rafibuet12/4bitSAP/Proteus Files+Others/4 BIT TOY.JPG

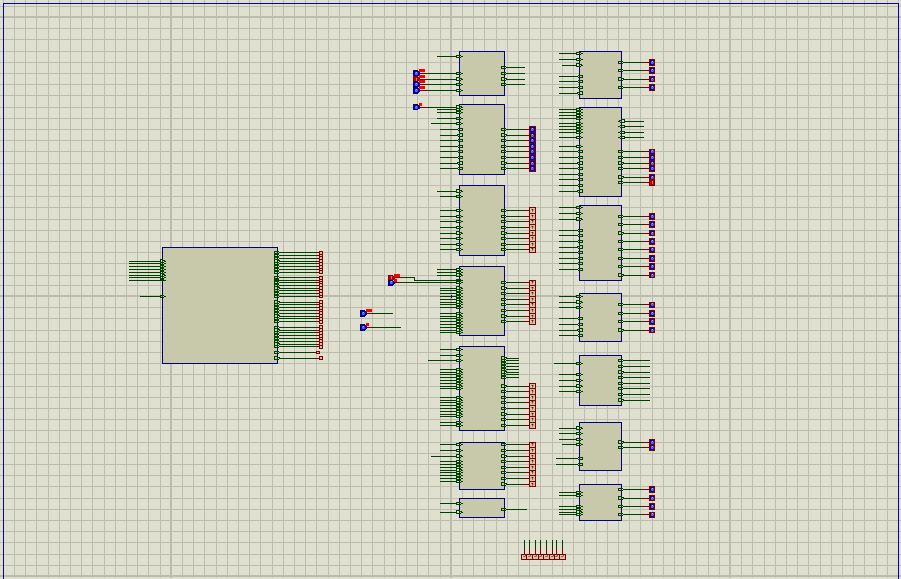
Proteus Files+Others/4 BIT TOY.JPG
