rafibuet12/4bitSAP/Report/4bit PC Report.pdf

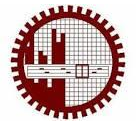
[picture p2: figure]

CSE404

Digital Systems Design Sessional
Design of 4-bit SAP
Section | B1
Group No. | 03
Writer’s Roll | 1205016
Writer’s Name | Rashid Abid Rafi
Group Members | 1205016 1205026 1205028 1205034 1205052
Date of Submission: | 15 November 2016

General Discussion & BLOCK DIAGRAM:

- Address BUS 8bit
- DATA bus 4 bit
- All data loading from BUS are sequential (Lsth) and all data emitting to BUS are combinational (Esth) (e.g: sth= MAR,MDR,IR etc.)
- The machine is edge triggered and both falling edge and rising edge are used in specific cases to perform specific purposes to avoid race conditions.

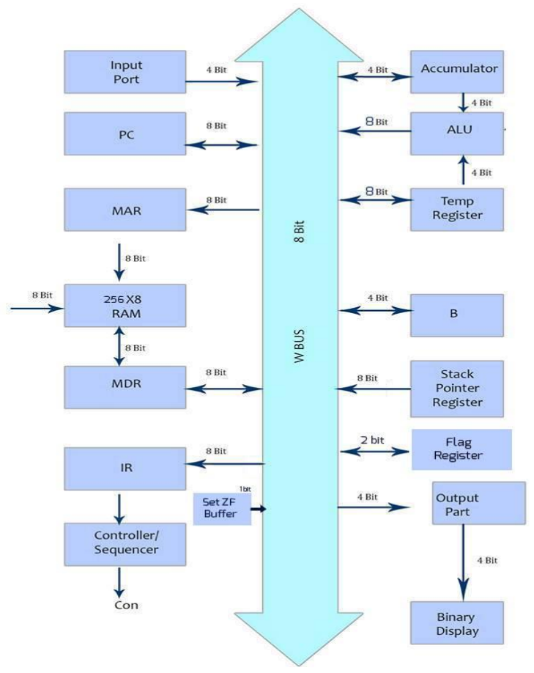
[picture p3: figure]

Input Register:

It is unidirectional with the bus: it only gives its data to the bus. That’s why only EIN. The task of input register is to take user input and pass the data to Accumulator via bus.

It is a data register, so only 4 bit transaction will suffice.

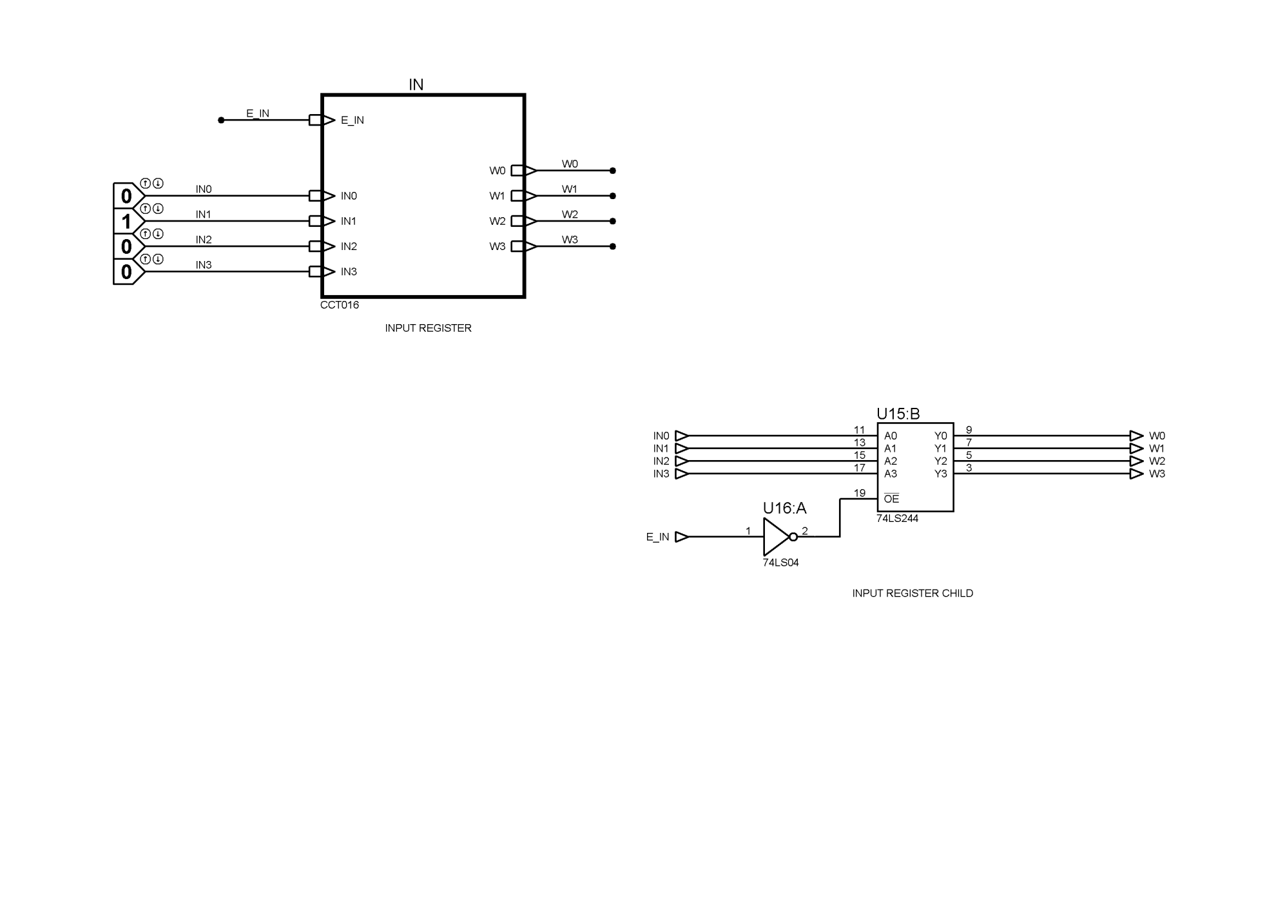
[picture p4: page 5]

PROGRAM COUNTER (PC):

PC is bidirectional with the bus. LPC loads data from the bus in a clock cycle and EPC lets it emit his data to the bus.

PC is an address register. That’s why it performs transactions in 8 bit.

There is a special bit PC_SP_SETUP in the design. There is a reason it is there. Eventually, when we will discover our RAM, we will see that the RAM stores data from the 1st address instead of 0th address. For this reason, PC is incremented by 1 forcefully at the beginning of running any program.

So, the incrementing needs a choice:

i) PC gets incremented by one at the beginning of the program by turning PC_SP_SETUP 1 forcefully.
ii) PC gets incremented when CP is 1 at the time of program running.

The MUX in this design selects between these two choices.

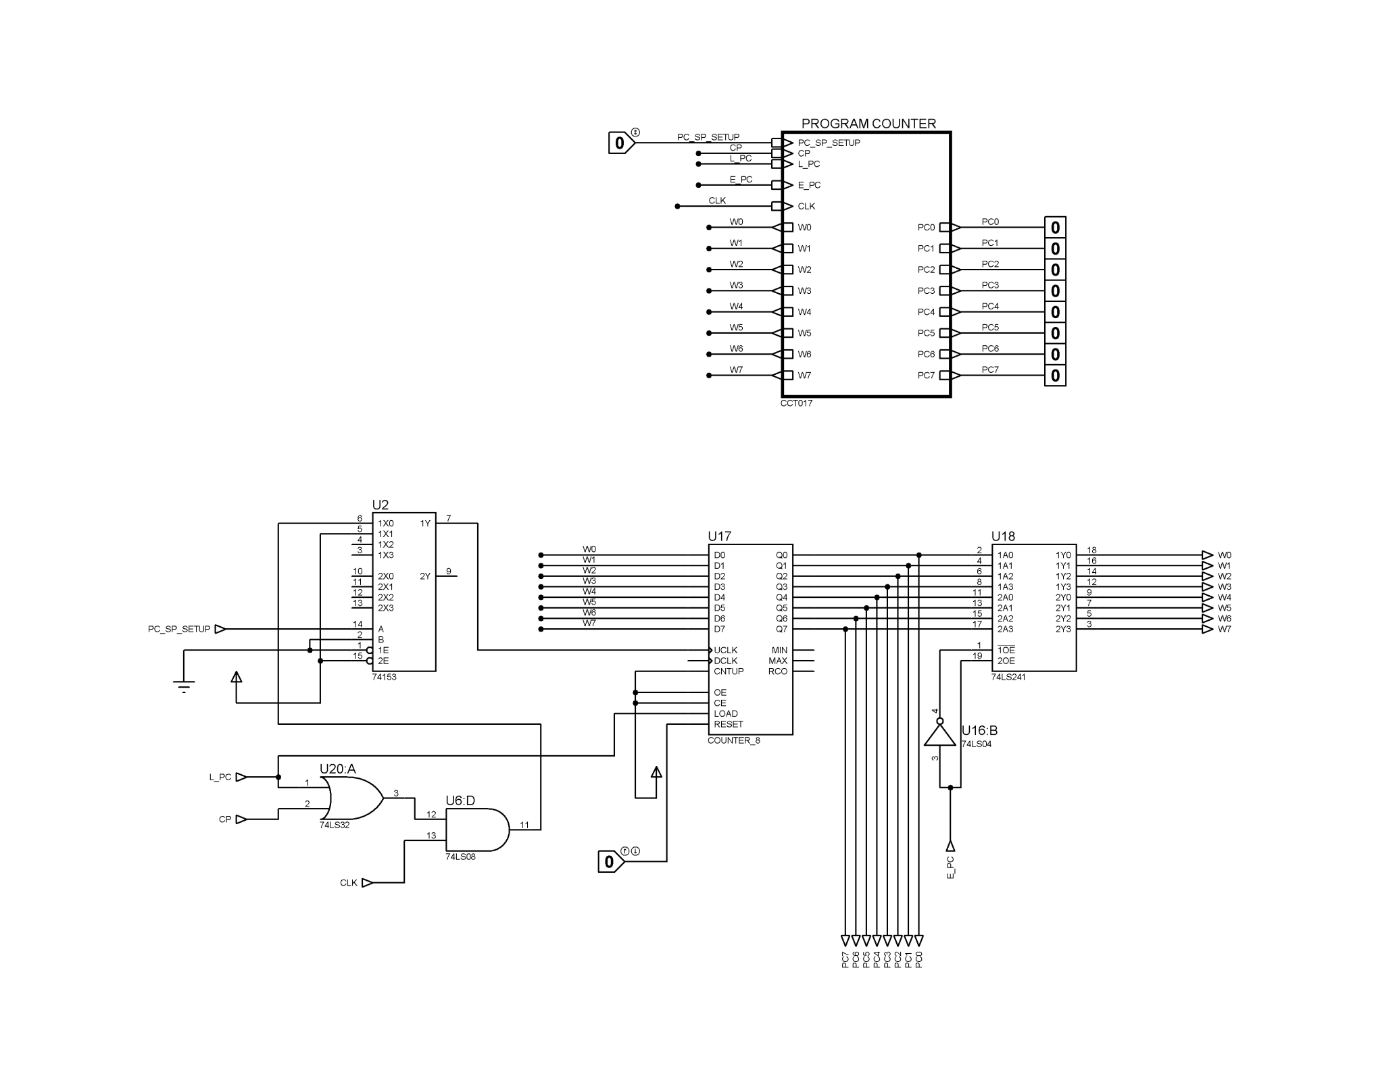
[picture p5: page 7]

MAR (Memory Address Register):

It is unidirectional with the bus: it only loads data from the bus. That’s why only LMAR.

The part of MAR with RAM is combinational. That means, whenever there is a data in MAR, RAM points to that address in the same clock cycle.

It is also an address register, hence 8 bit transaction.

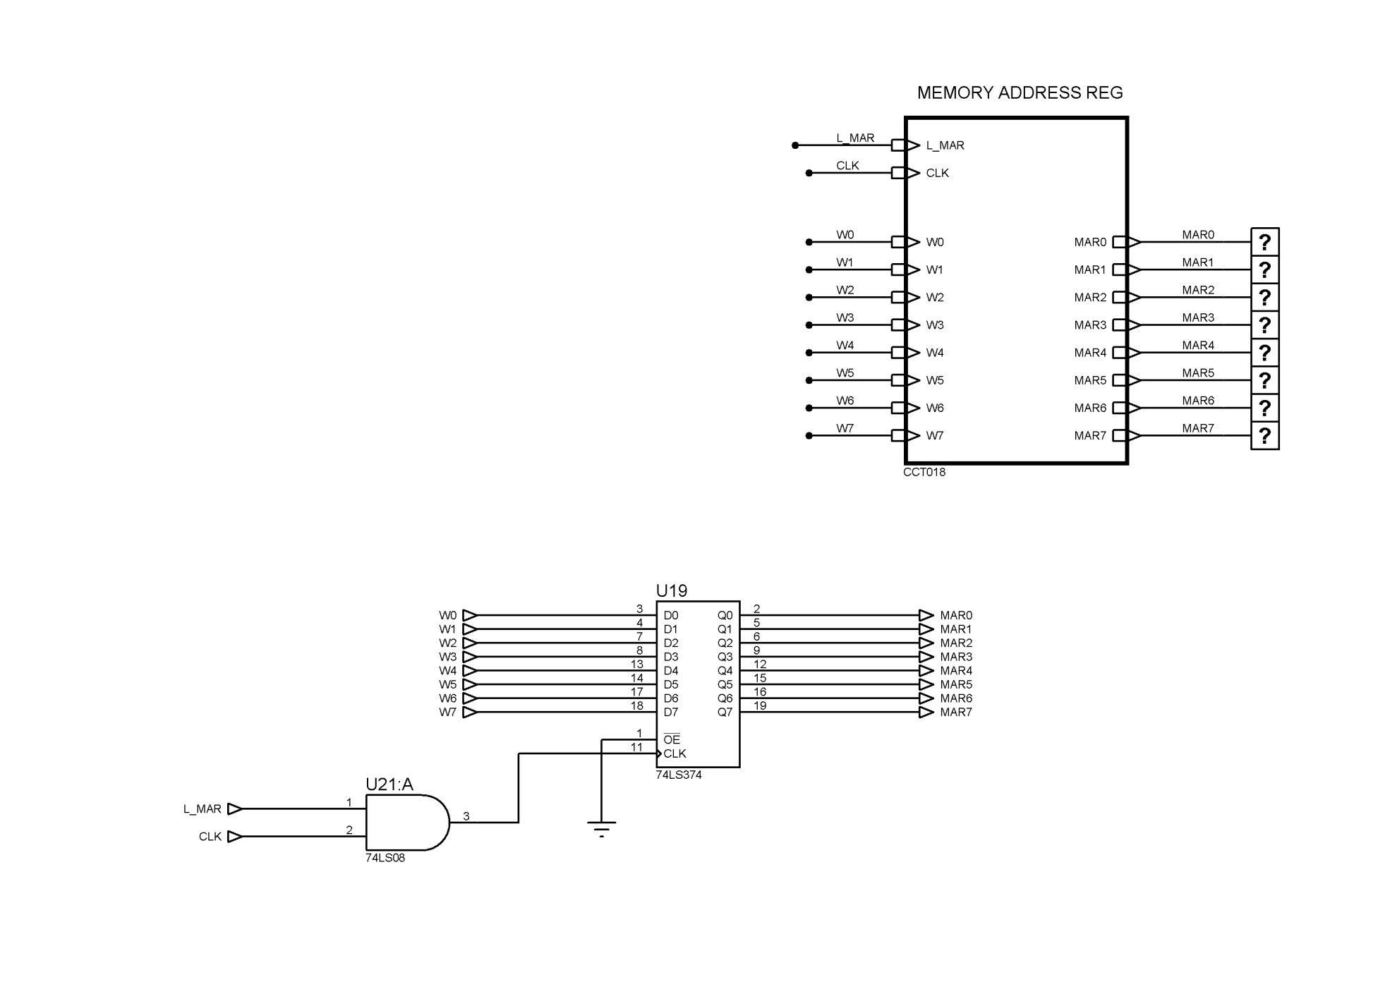
[picture p6: page 9]

RAM (Random Access Memory):

Our address bit is 8 bit. So, we need to implement a 256x8 RAM.

There is no connection of BUS with RAM directly. In fact, the design was specific about this not to have any direct connection with the BUS. For this reason, the two registers: MAR & MDR are used.

The whole design constitutes of two parts:

i) Uploader/ Boot-Loader : When Up_INIT is on, with every clock pulse at UP_INIT_CLK, the assembly program, which the PC is about to run, pre-saved in the EPROM in the form of Machine Language gets loaded byte by byte and written into RAM.
ii) | Normal Read/Write Operation: Only after the whole assembly program is loaded
| into RAM, typical read/write operations starts according to the CLK and R_RAM,
| W_RAM bit.

Functionality:

- Read Operation: When there is CE(Chip Enable) on and WE(Write Enable) off, provided that OE(output Enable) always remains on, a read operation happens. It reads the data from the address A0-A7 and outputs data into the D0-D7 pins.
- Write Operation: When there is CE(Chip Enable) on and WE(Write Enable) on, provided that OE(output Enable) always remains on, a write operation happens. It writes the data from the data pins D0-D7 into the address specified in A0-A7 pins.
- MUX: The ram operates to serve two purposes. One is for boot-loading the program and the other is the normal read/write operation. For this choice making, a MUX is used along with proper combinational logic to control the RAM.

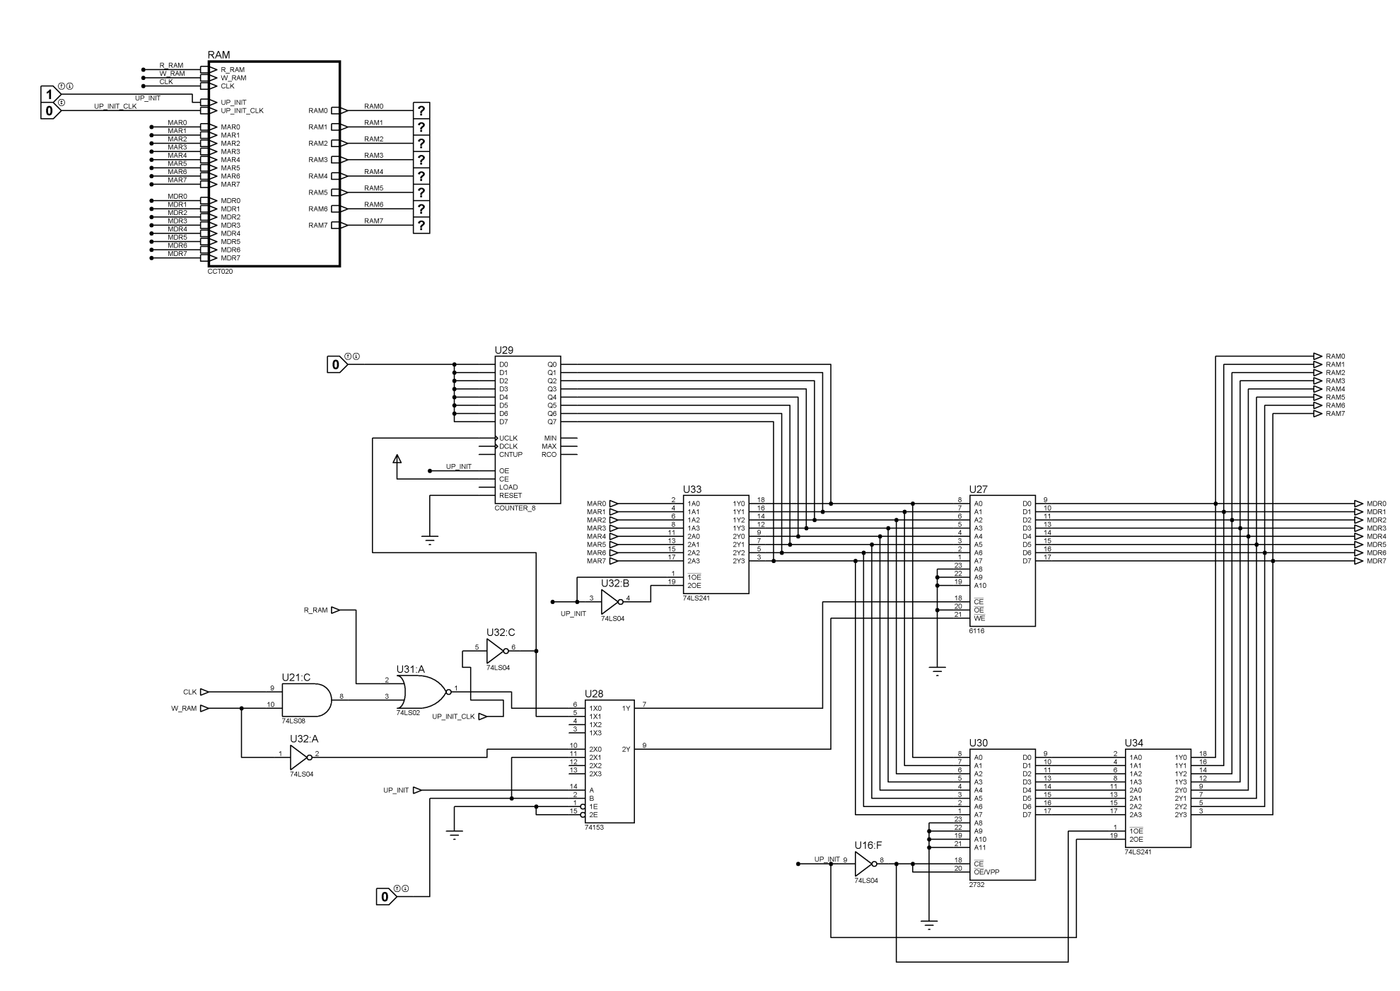
[picture p7: page 12]

MDR (Memory Data Register):

MDR is bidirectional with the bus. That’s why LMDR & EMDR.

It can contain 4 bit data or 8 bit address as a data, too. That’s why it is 8 bit register.

MDR is bidirectional with RAM, too.

i) When R_RAM is on, MDR reads data from RAM and stores within. It needs a clock cycle.
ii) | When W_RAM is on, MDR writes its data at RAM at the address pointed by MAR.
| It needs a clock cycle.

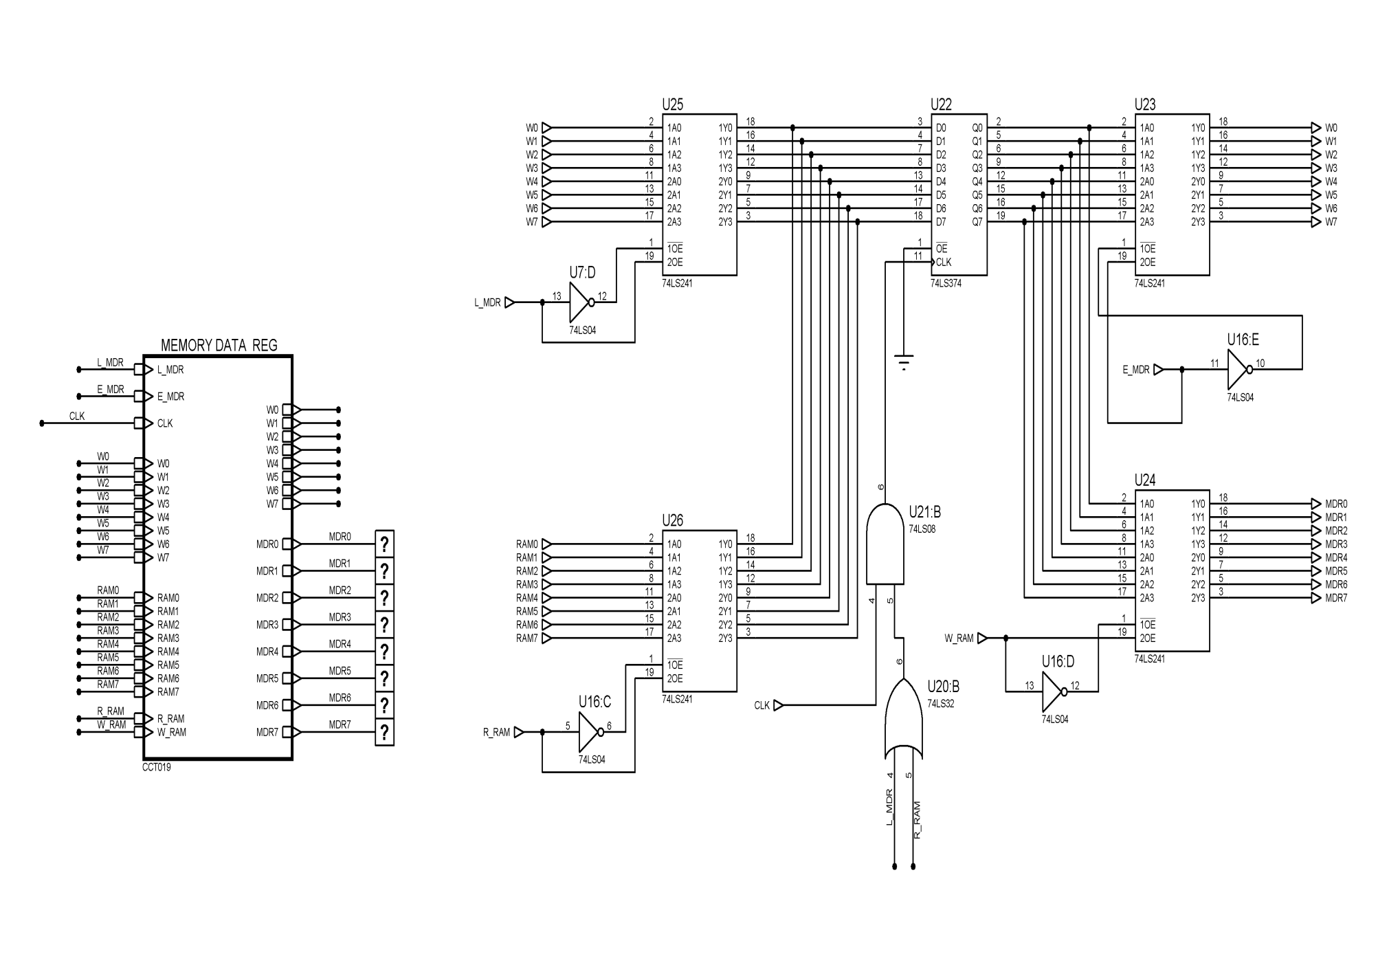
[picture p8: page 14]

IR (Instruction Register) :

It is unidirectional with the bus. It only loads data from bus.

i) L_IR1 loads 6 bit from bus. The first 5 bit(bit0-bit4) is the opcode.
ii) L_IR2 loads 2 bit from bus. These are the two flag bits: Carry Flag(bit6) and the Zero Flag (MSB or bit7).

It has a combinational connection with the CONTROLLER. That means, it passes its 8 bit data directly to the controller.

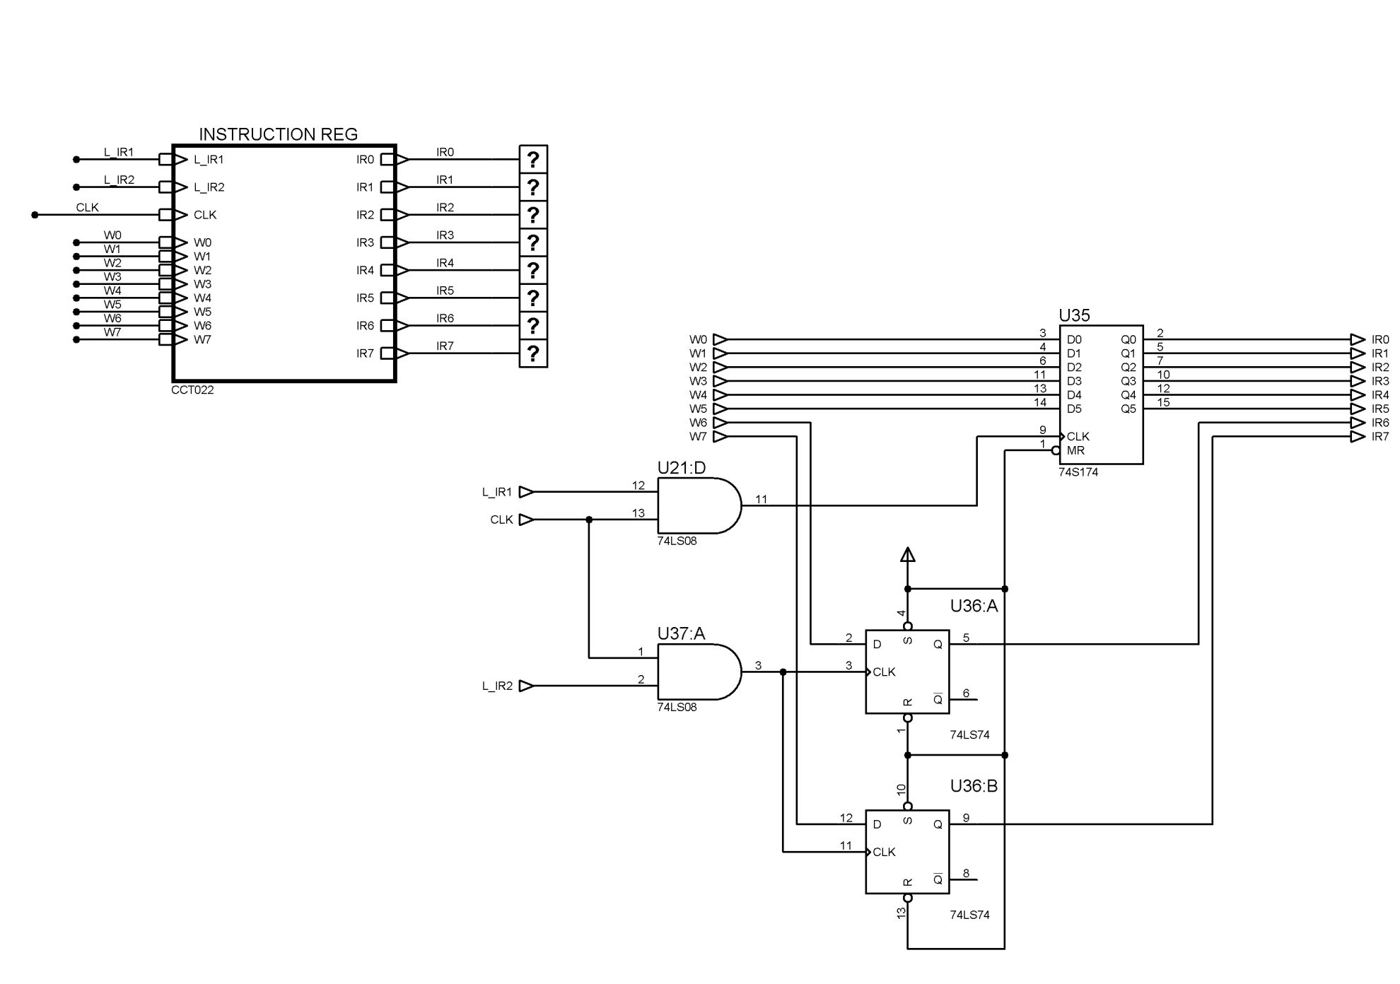
[picture p9: page 16]

SET ZF BUF (Set Zero Flag Buffer):

It is a tri-state buffer. Its job is to set/ clear the W7 bit (MSB) of bus.

It is a buffer, so unidirectional with the bus and hence ESET_ZF_BUF

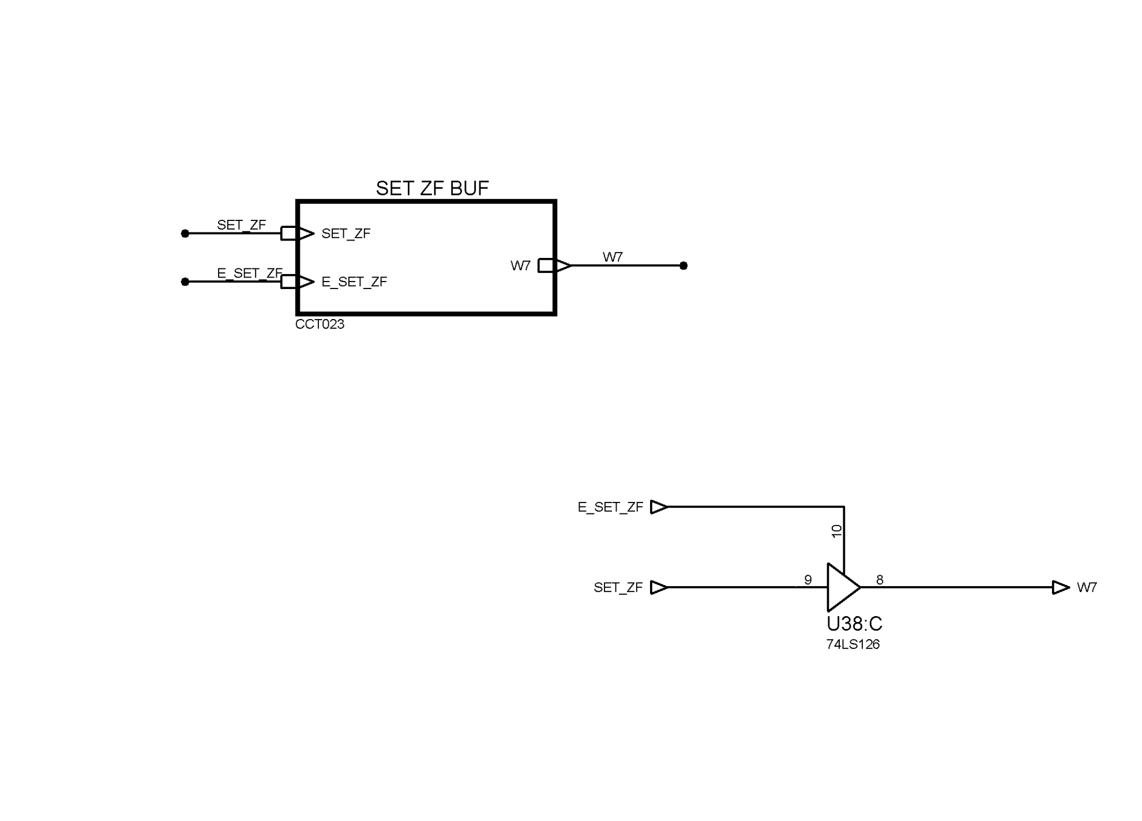
[picture p10: page 18]

ACCUMULATOR:

It is bi-directional with the bus. Hence, LA & EA.

It has a combinational connection with the ALU. That means, whenever there is data in Accumulator, it passes to ALU in the same clock cycle.

It is a data register, hence 4 bit transaction.

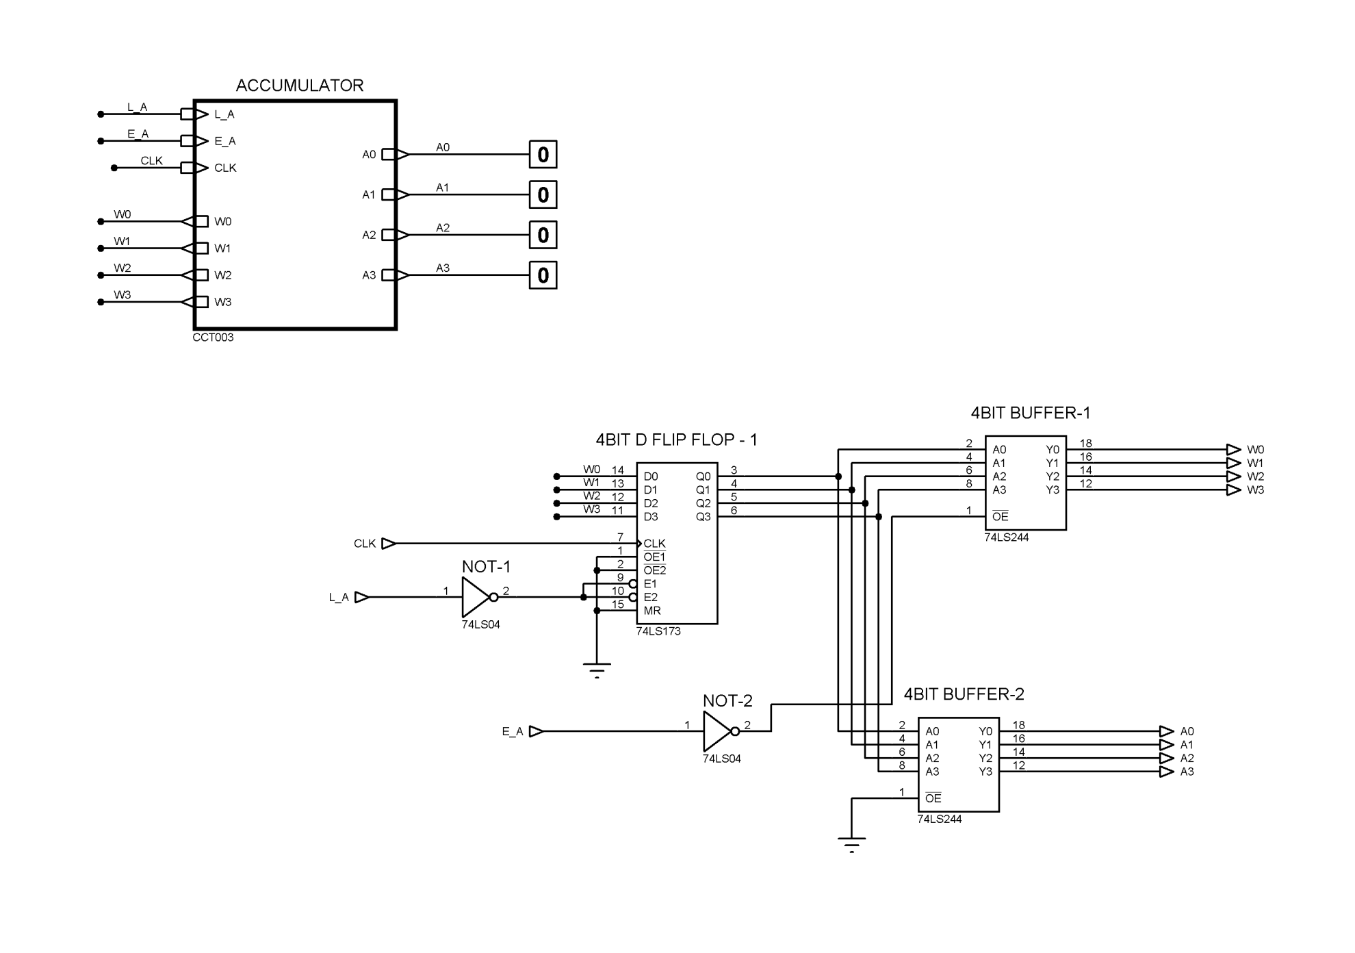
[picture p11: page 20]

ALU (Arithmetic Logic Unit):

The design is called 4-bit PC because our ALU operates on 4 bit data. There are direct connections from Accumulator & Temp Reg to ALU. That means, as soon as the data in these two updates, ALU performs its operation according to its control bits.

i) EALU lets ALU emit its data to bus
ii) EADD & ESUB performs the arithmetic operation.
iii) EAND & EOR performs the logical operation.

If we notice, we can see that there is no direct connection from ALU to FLAG Register. That means, whenever ALU performs an operation, the corresponding flags are to set by us manually. For this reason, ALU computes the flags each time an operation happens and it sends them in W6-W7 (Carry Flag and Zero Flag respectively), whereas the computed 4 bit data is sent to W0-W3.

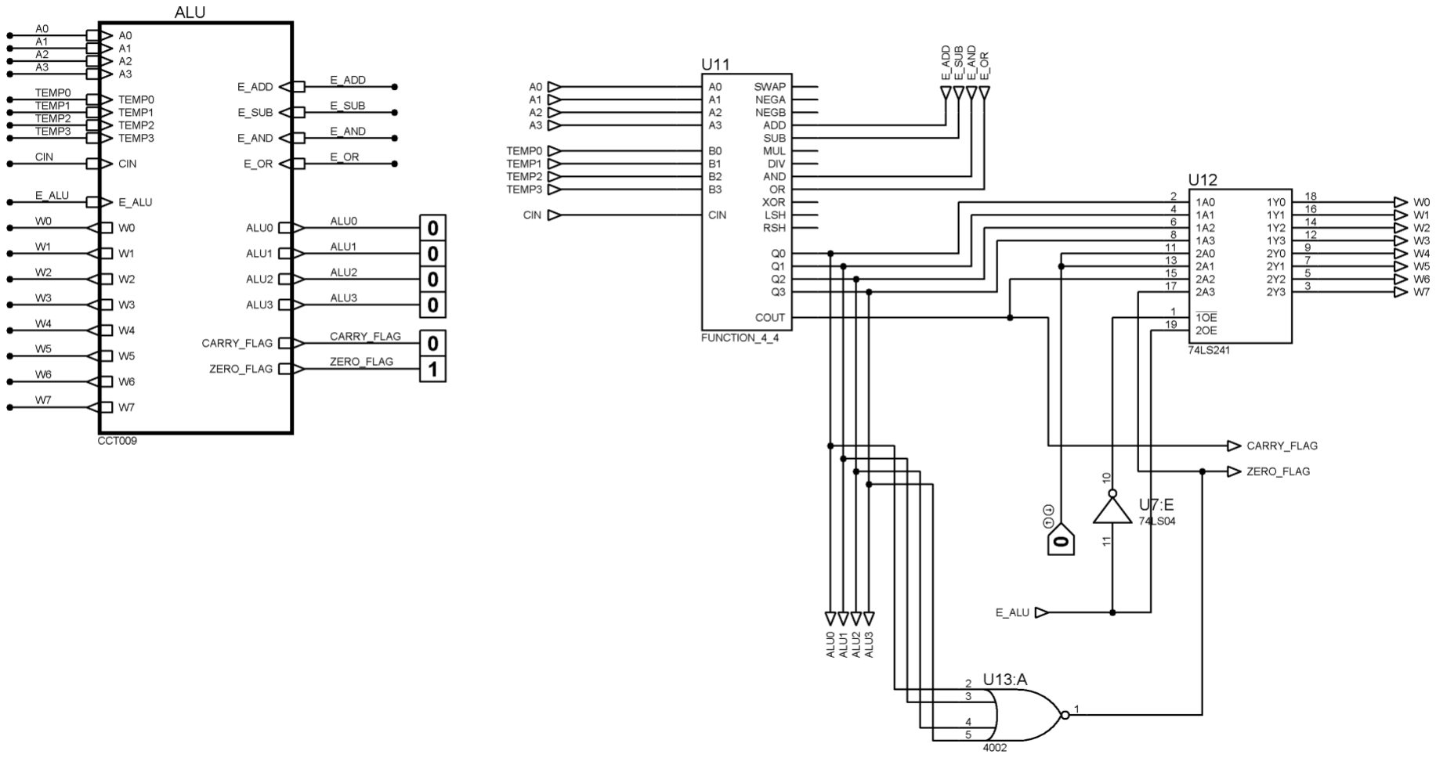
[picture p12: figure]

TEMP Register:

It is bidirectional with the bus, hence LTEMP & ETEMP.

It has a direct connection with ALU. That means, whenever the data in TEMP changes, ALU updates.

In our design, TEMP Register can also hold address value temporary. That’s why its 8 bit register in design.

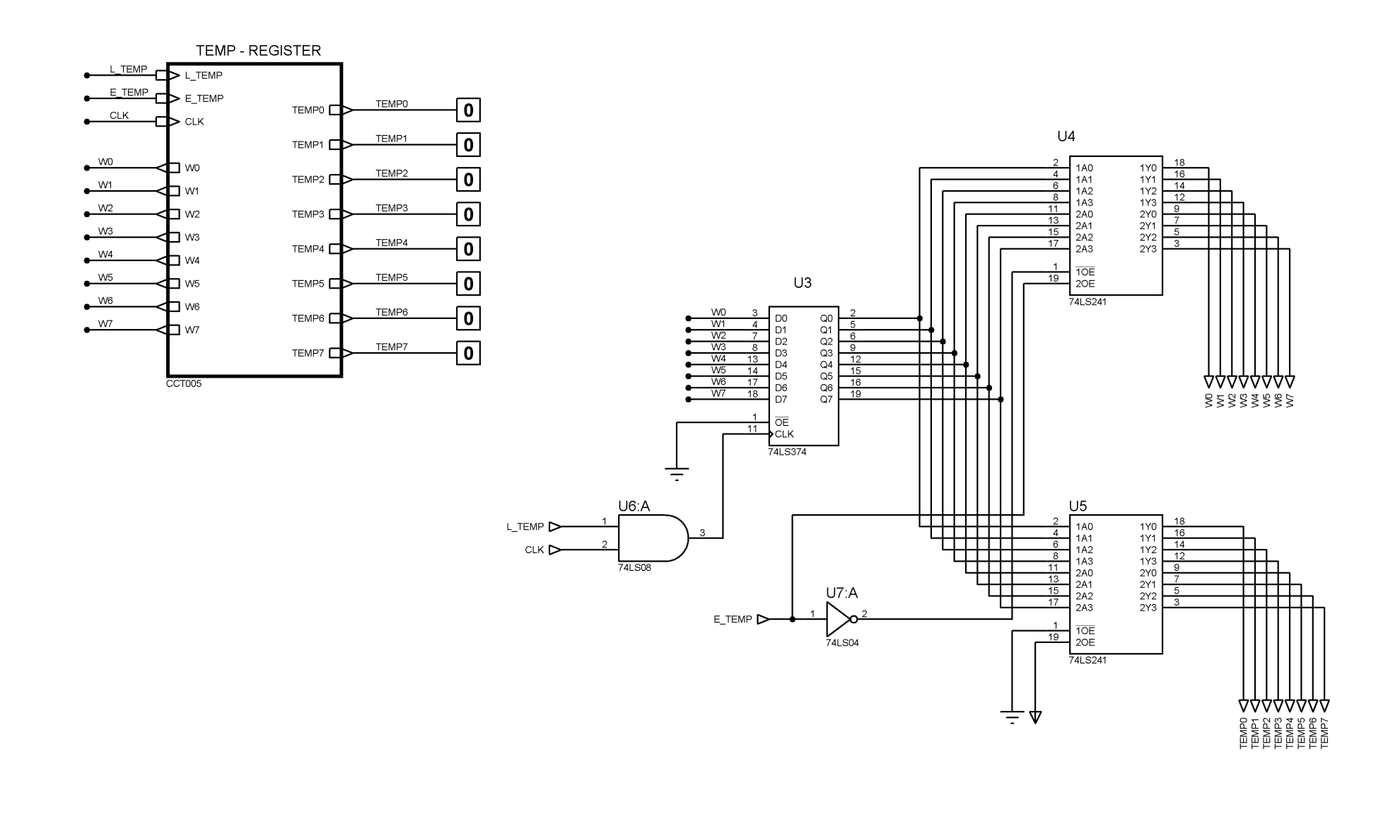
[picture p13: figure]

B Register:

It is also a bidirectional data register like Accumulator unlike it has no connection with ALU directly. Any data from B Register goes to ALU via Temp Register.

Its bidirectional with bus, hence LB & EB.

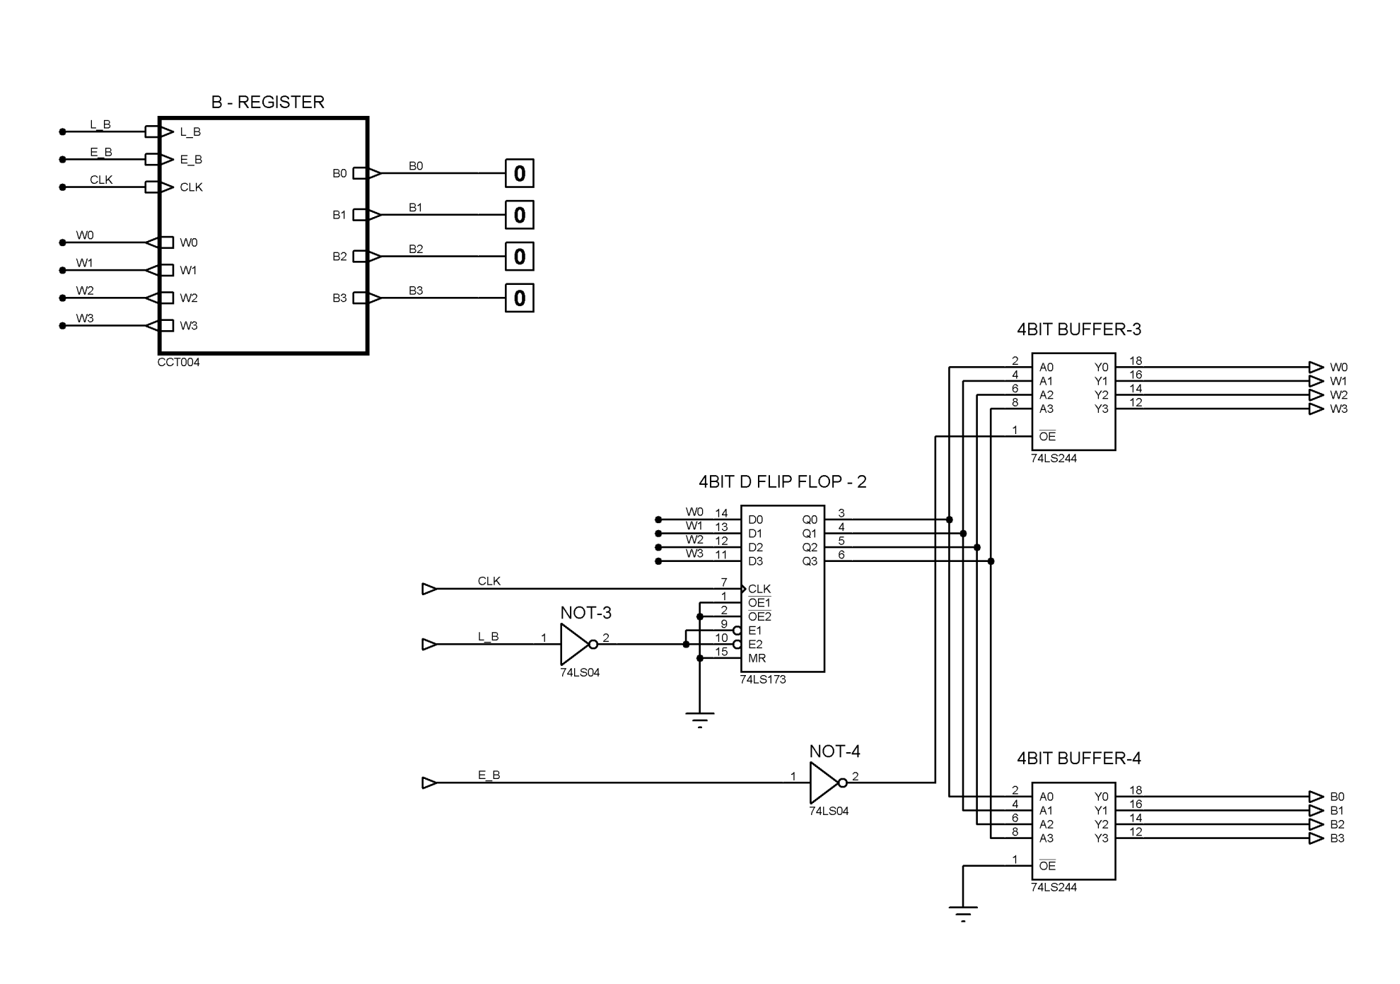
[picture p14: page 26]

STACK POINTER:

This register manages the TOP of the stack. It always holds the address of the TOP of the stack.

It has a special bit PC_SP_SETUP. It initially sets SP address to the desired address location at the beginning of the program running.

It can both increase and decrease, that’s why USP (Up Counter)& DSP (Down Counter).

It is unidirectional with the bus, it can only give its data to the Bus. Hence, ESP.

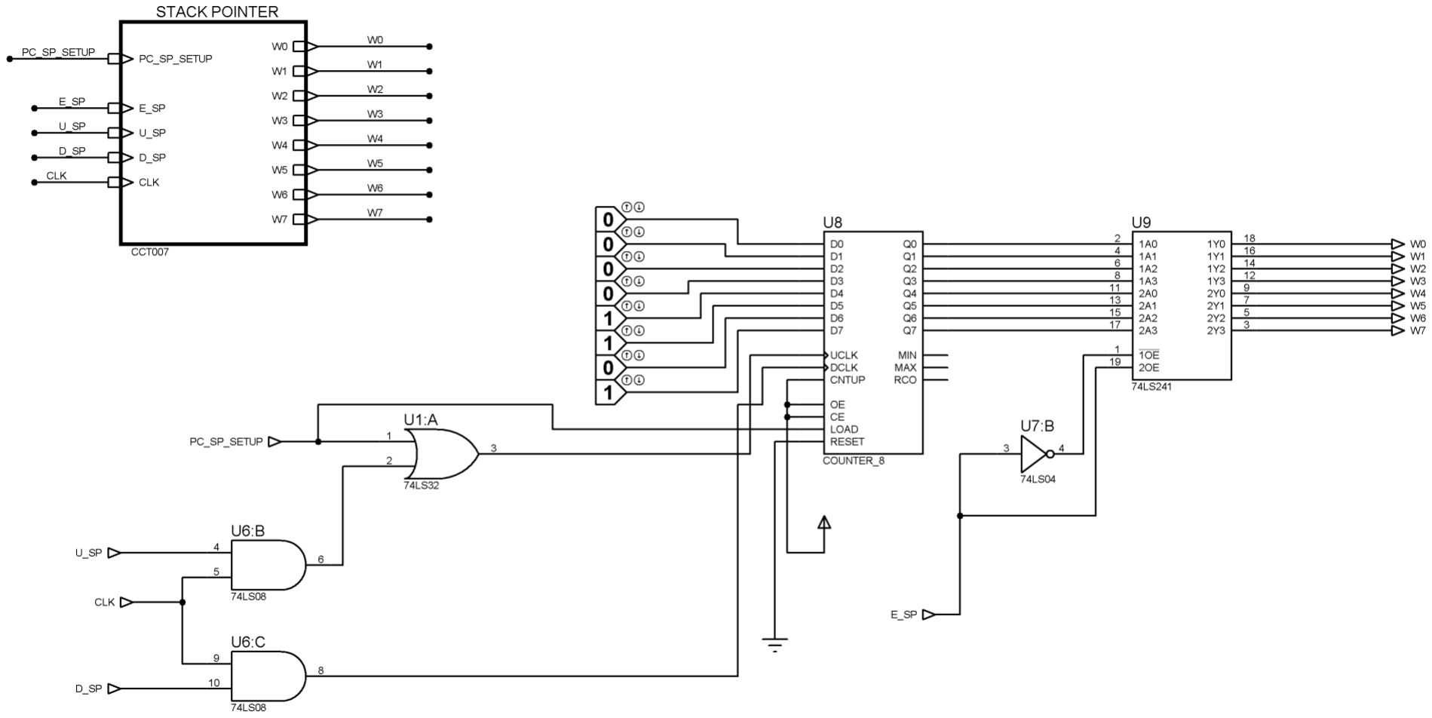
[picture p15: figure]

FLAGS REGISTER:

It is 2 bit data register. It just loads W6 & W7 bit bus data and saves in it as Carry Flag(W6) and Zero Flag (W7).

i) L_FLAGS loads both CF & ZF
ii) L_FLAGS_Z loads only W7 data (ZF)
iii) E_FLAGS lets it emit its 2 flags in 2 bits.

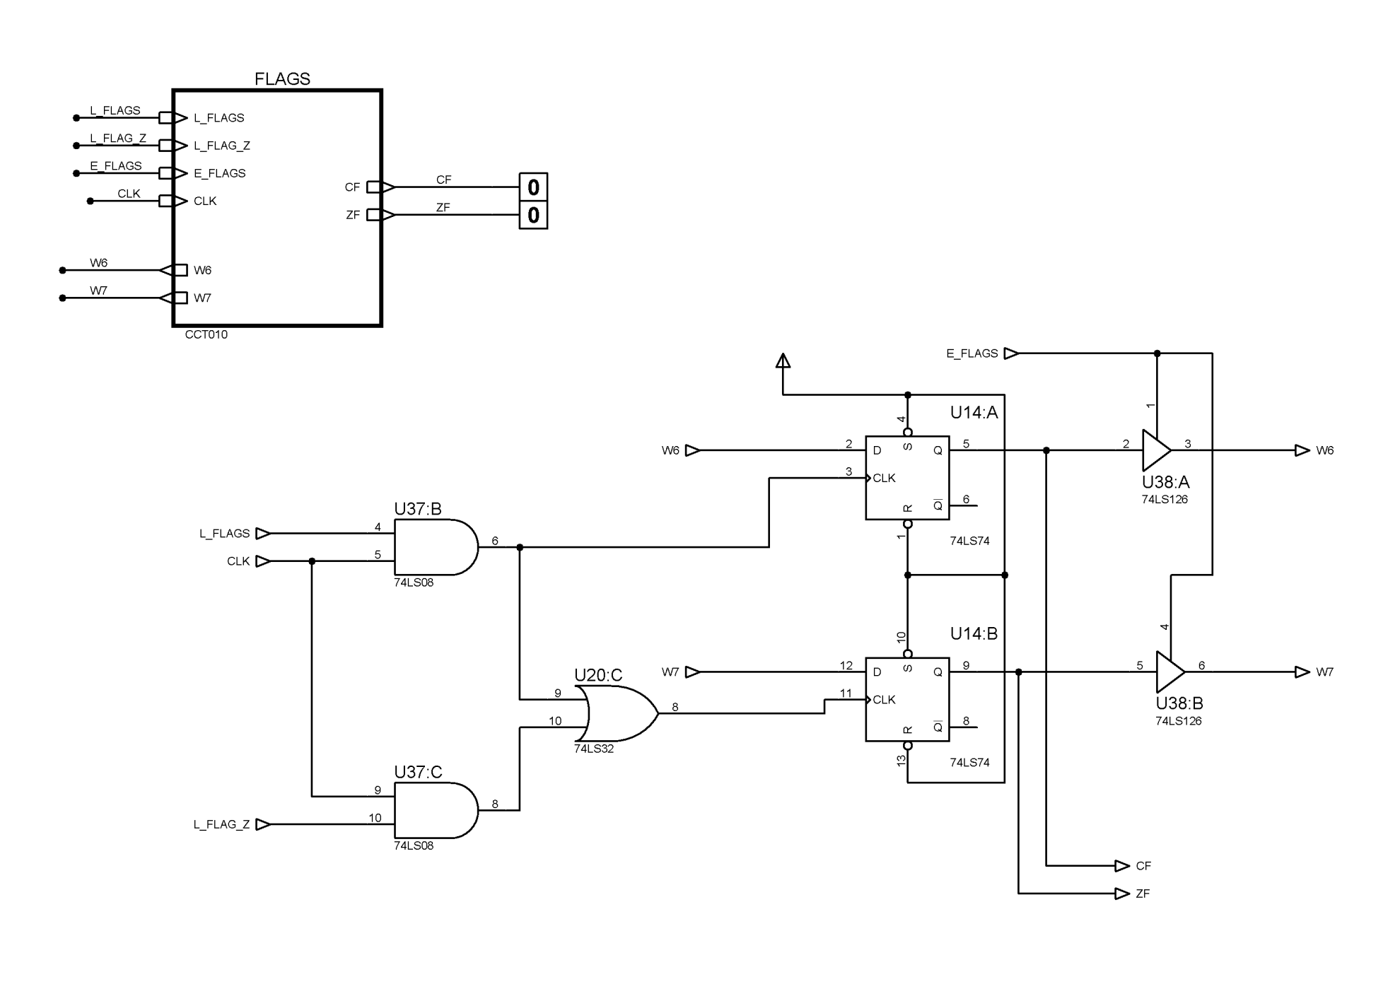
[picture p16: page 30]

OUT:

OUT register loads 4 bit data (W0-W3) from the bus and shows it to the binary display.

It is unidirectional with the bus, it only loads data from the bus. Hence, LOUT only.

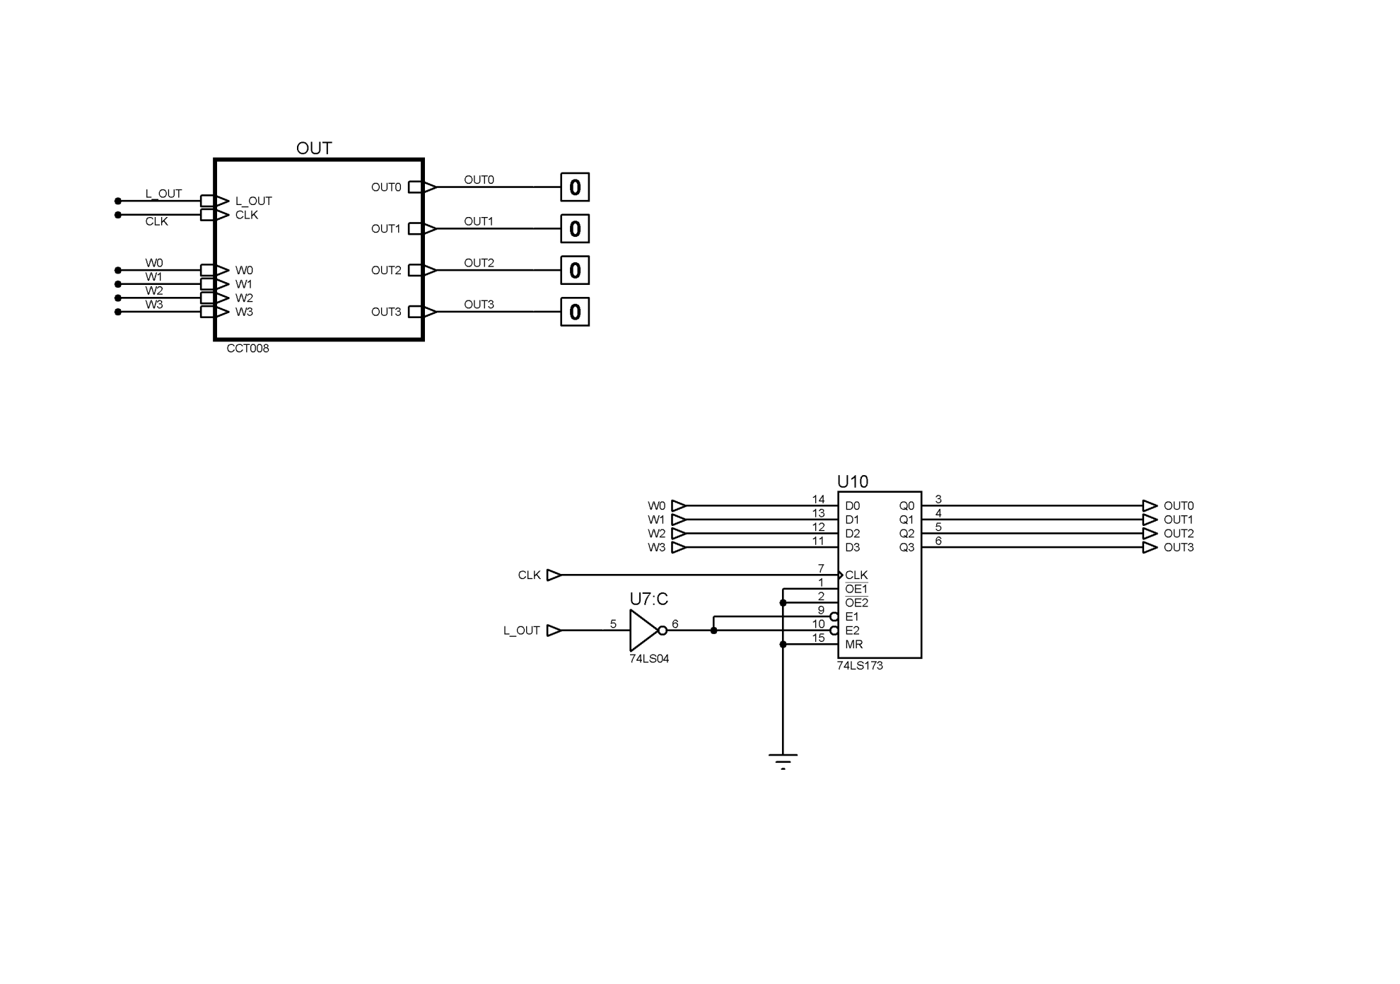
[picture p17: page 32]

CONTROLLER:

This is the core part of the design or “Heart of Design.”

It generates 40 bit control word for each T-state of each instruction. Each Control word gets generated into the falling edge of the clock whereas each sequential execution gets executed in the rising edge of the clock.

## CONTROL WORD (CON):

## EINCPLPCEPC|LMARRRAMWRAMLMDR|| (EPROM1)

## EMDRLIR1LIR2SETZF|ESET_ZFLAEACIN ||(EPROM2)

EALUEADDESUBEAND |EORLTEMPETEMPLB ||(EPROM3)

EBESPUSPDSP | LFLAGSLFLAG_ZEFLAGSLOUT ||(EPROM4)

## CTRLCTRRCTRCCTRZ |SADDHLT 0 0 (EPROM5)

Functionality:

- There was a direct connection with the instruction register to the controller. For this reason, it could take opcodes from IR as direct inputs.
- After taking opcodes(IR0-IR4) it searched an EPROM for address where the control word for the associated instruction was loaded.
- There is a MUX for iterating into the CONTROLLER_ROM for fetching pre-saved control word associated with that particular T-state
- CTR_C,CTR_Z,CTR_L, ,CTR_R these four control bits were used to control the MUX in order to take decision whether to reset the counter or not.
- In CONTROLLER_ROM, 5 EPROMs were cascaded ot produce a 40 bit control word according to the definite format stated before.
- We had 93 T-states in total. For this reason, CONTROLLER_ROM had to have 7 bits to iterate within. ( 93< 2^7=128)
- Another MUX was used in order to control CIN. In case of Special add instructions (like ADC, SBB) we had to control CIN. For this reason, a sepearte control bit SADD was introduced to control this MUX.

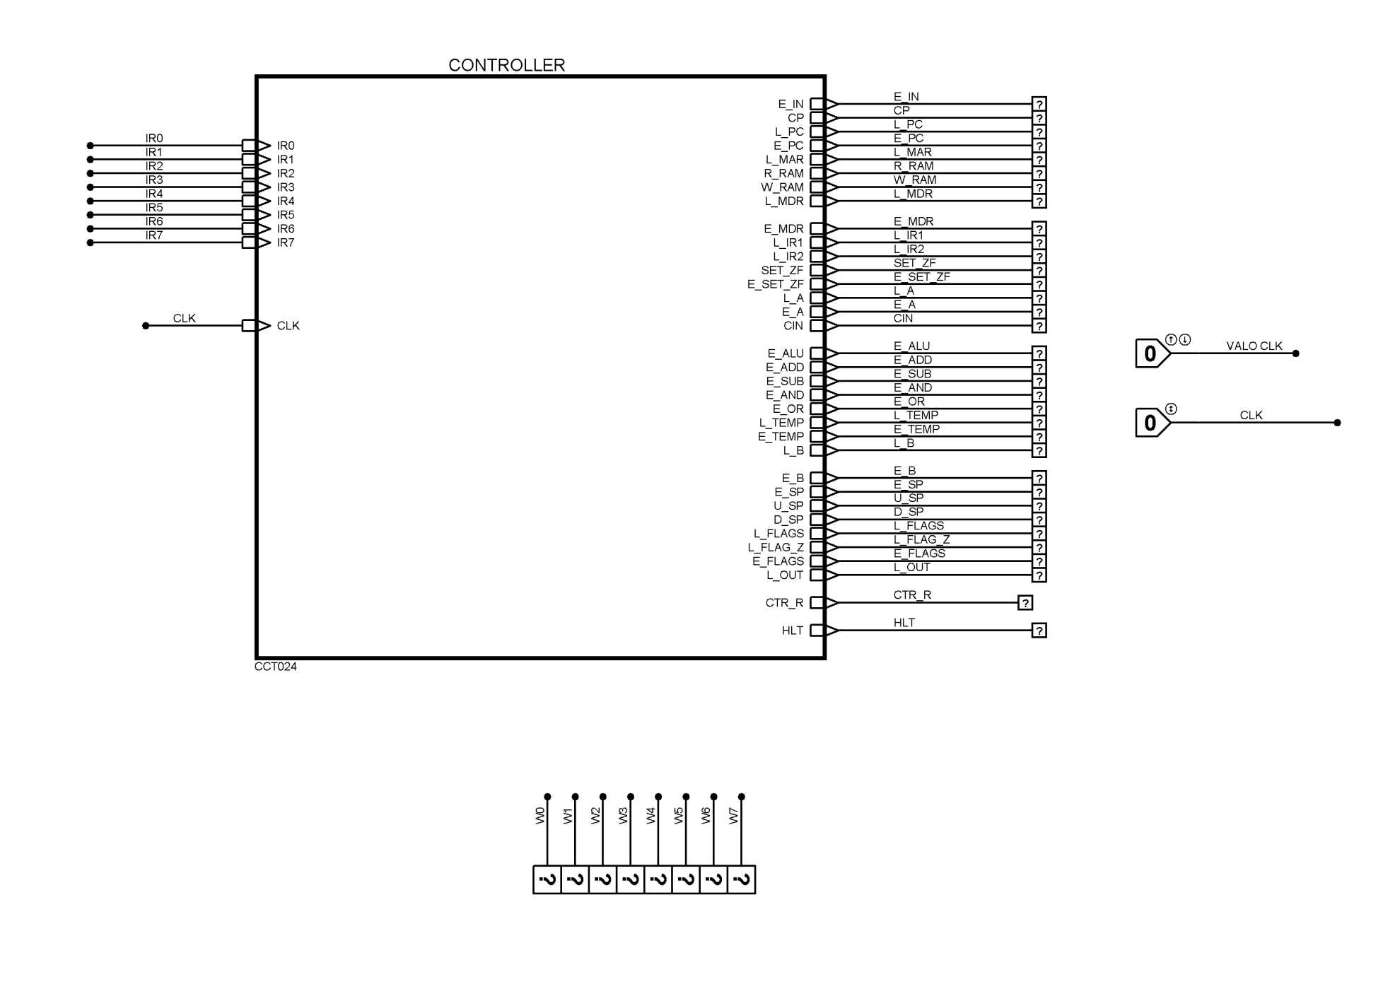
[picture p18: page 35]
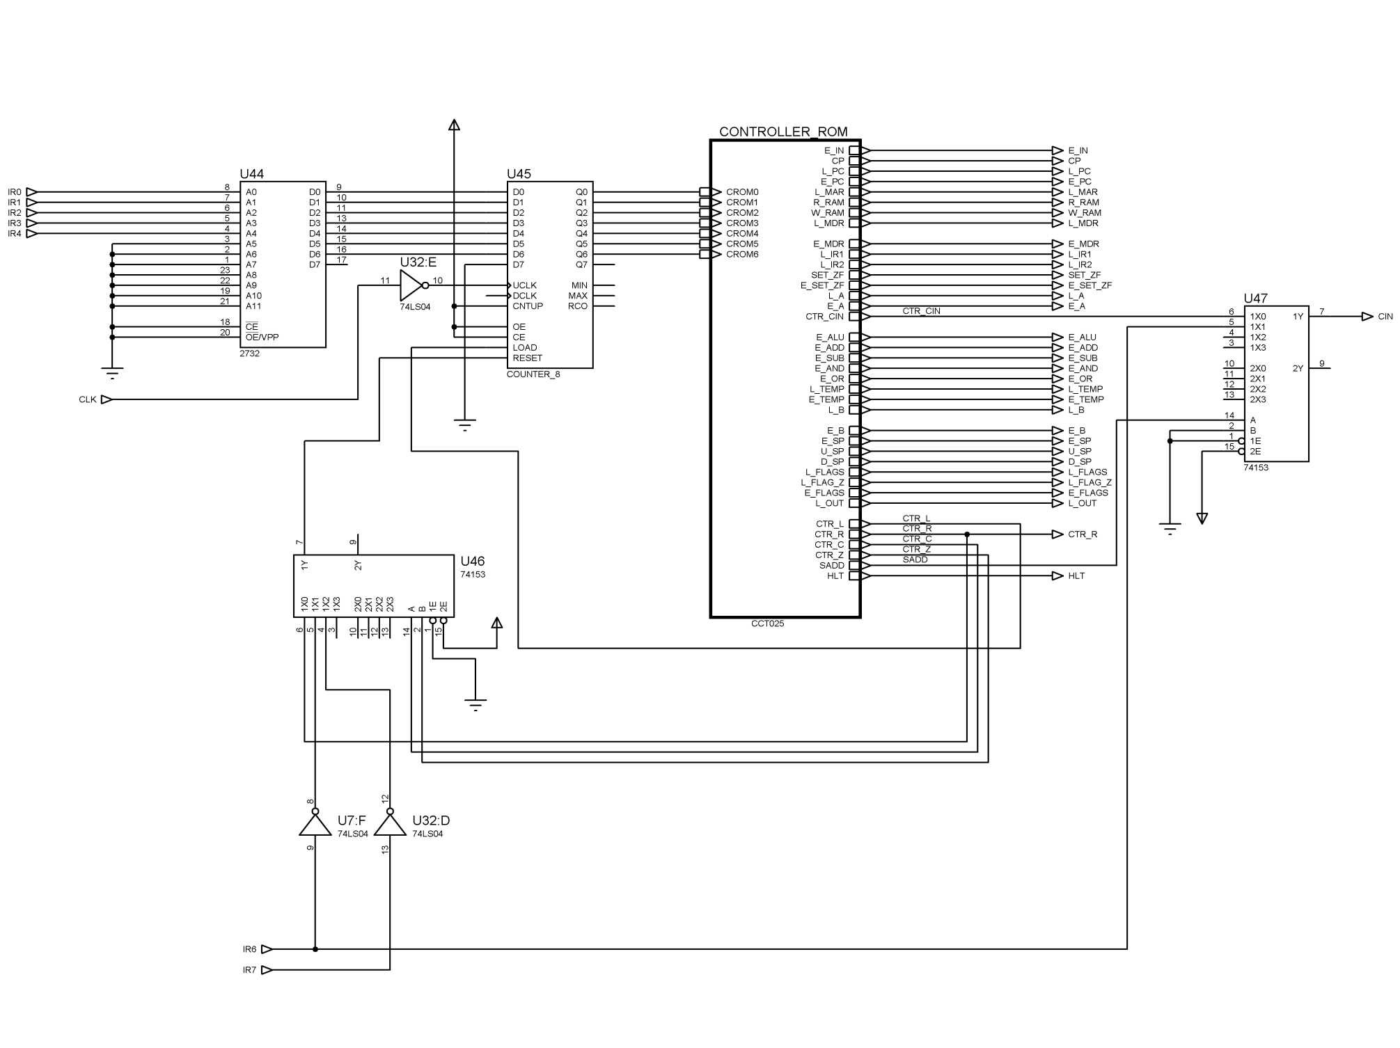
[picture p19: page 36]

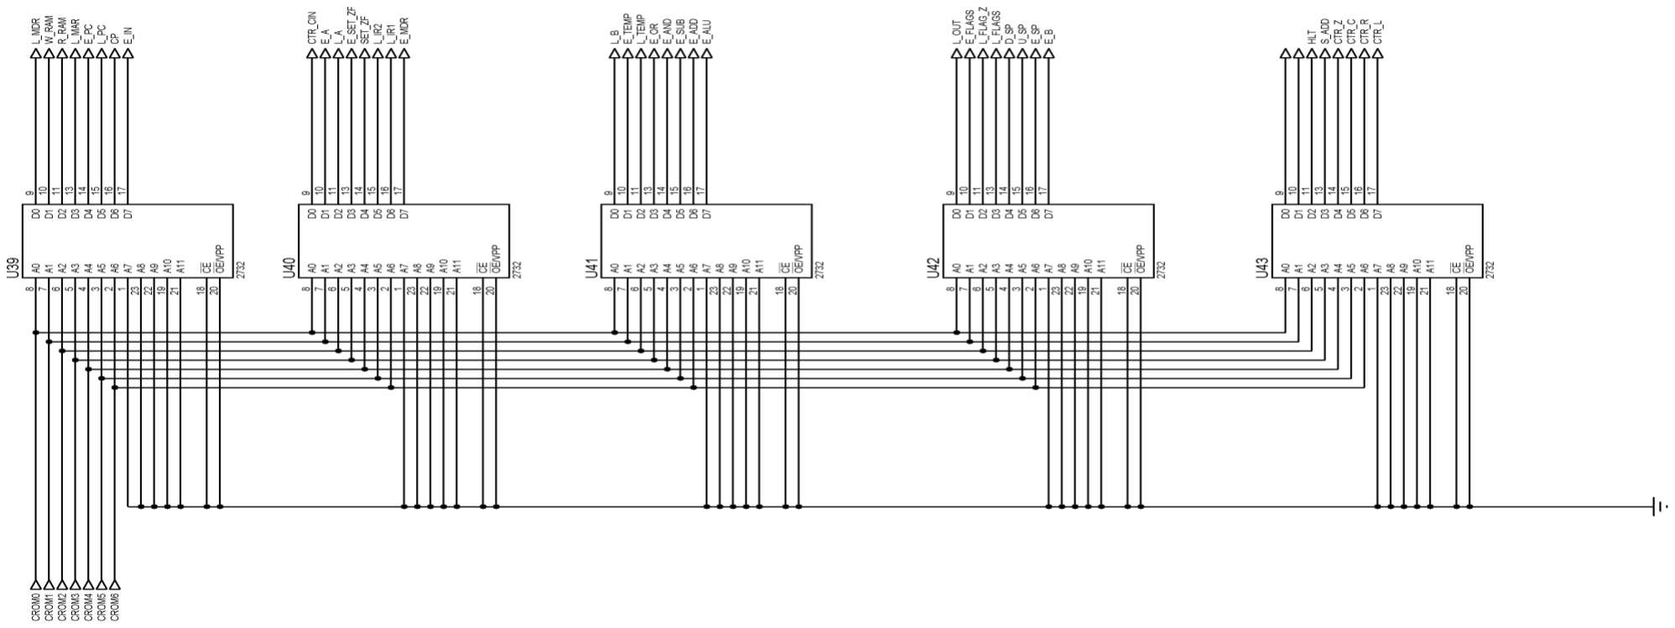
[picture p20: figure]

BIN FILES:

Bin files are saved into specific folder. One can modify it but he/she has to understand thoroughly how the bin files were pre-saved at the first case.

- bin1.bin : EPROM1
- bin2 .bin: EPROM2
- bin3 .bin: EPROM3
- bin4 .bin: EPROM4
- bin5 .bin: EPROM5
- opcode.bin: keeps the starting address of Execution cycle of that particular opcoded instruction.
- Assembly.bin: stores the HEX Code of assembly program (with these 28 instruction

sets.)

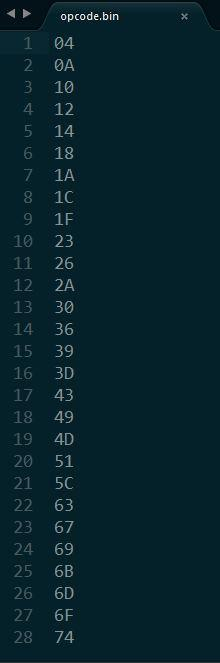
[picture p21: figure]

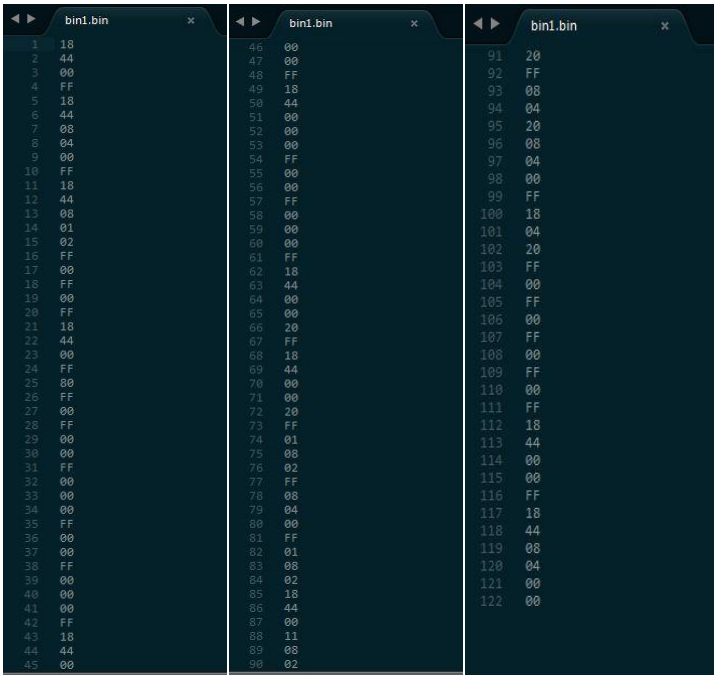
[picture p22: figure]

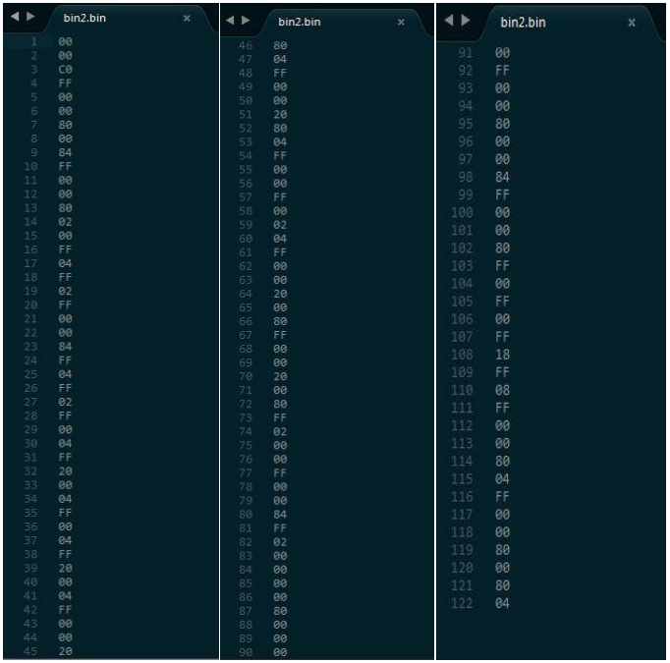
[picture p23: figure]

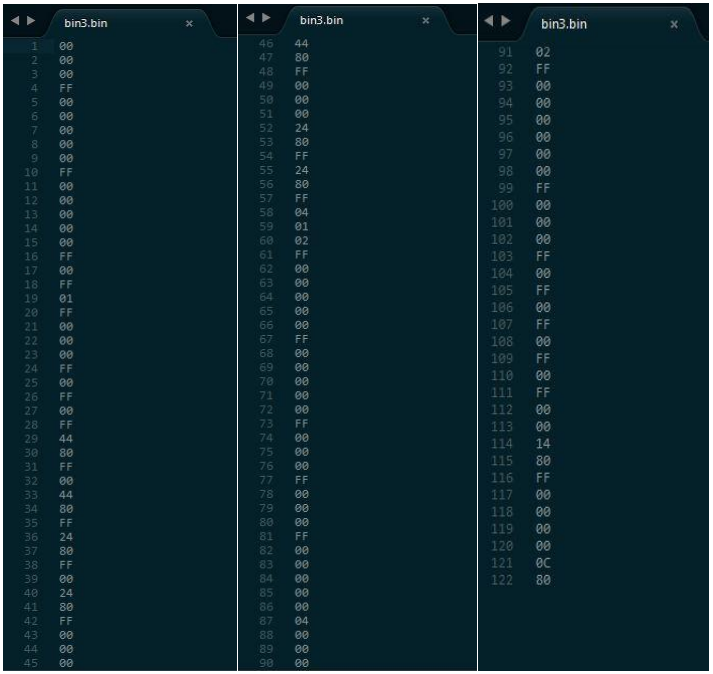
[picture p24: figure]

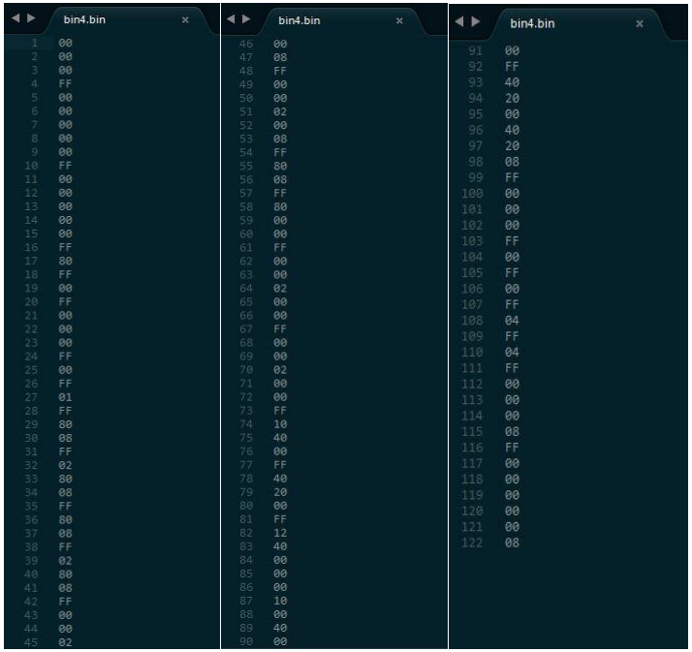
[picture p25: figure]

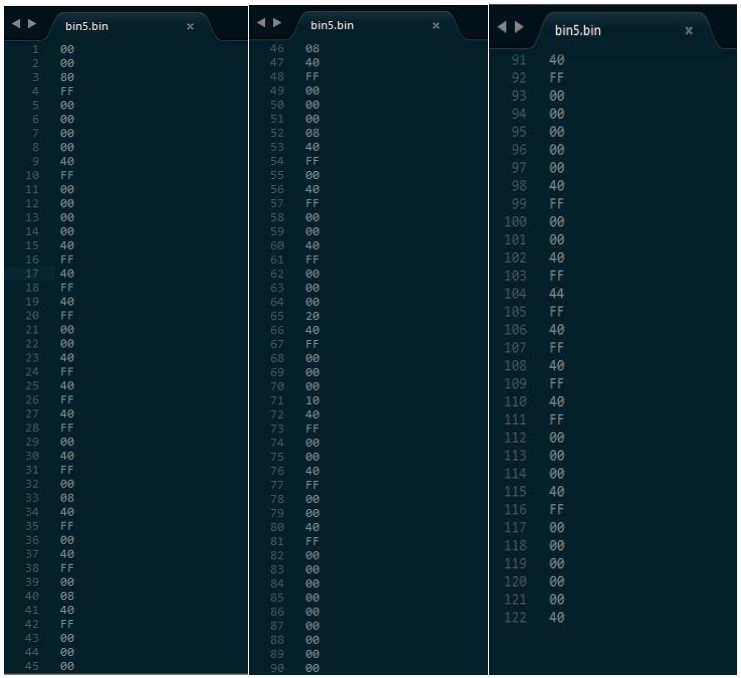
[picture p26: figure]
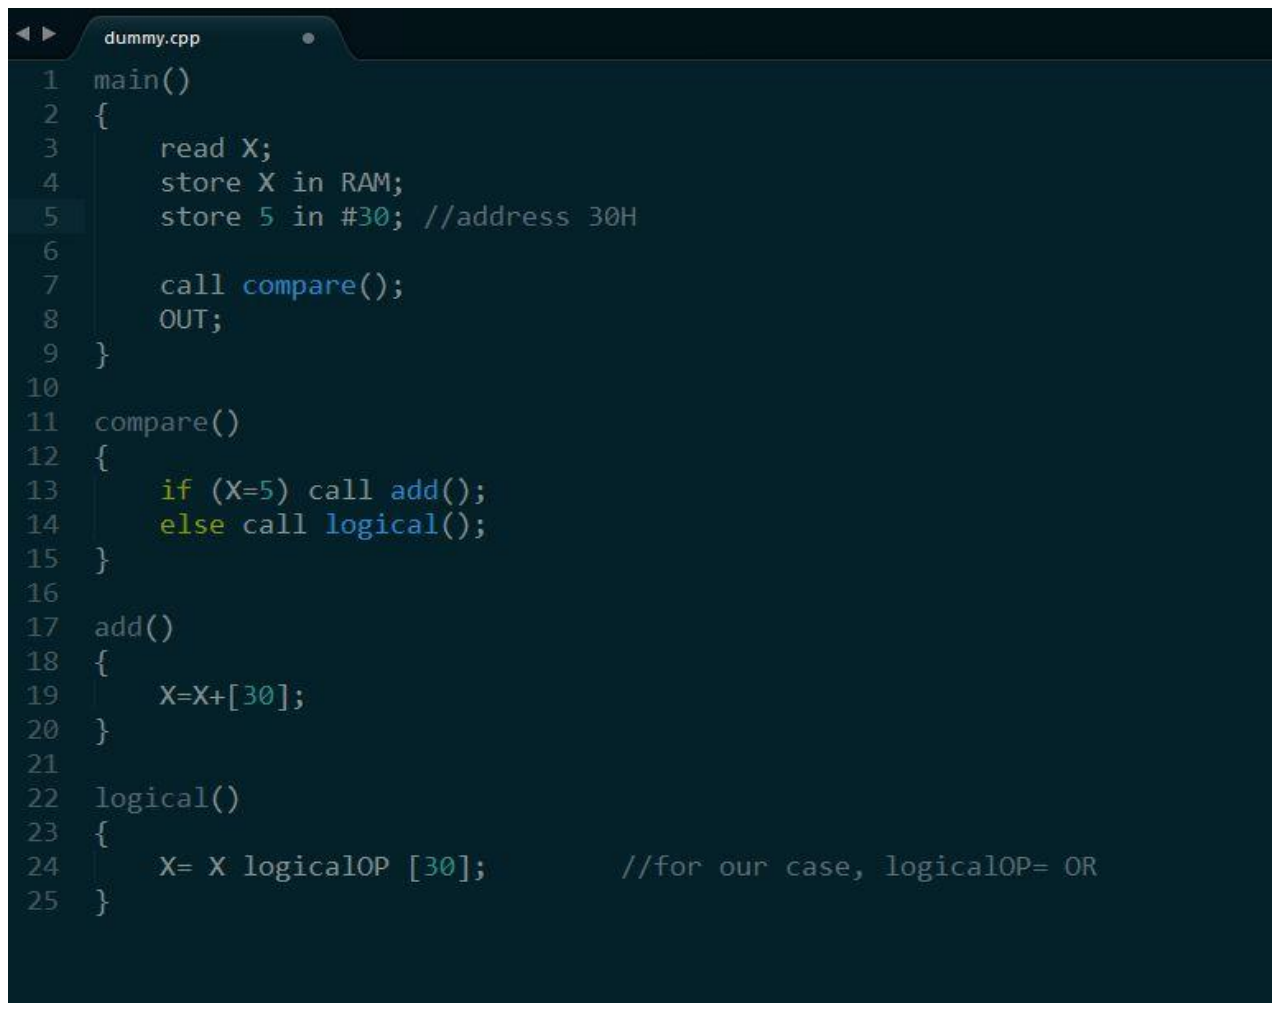
[picture p27: page 45]

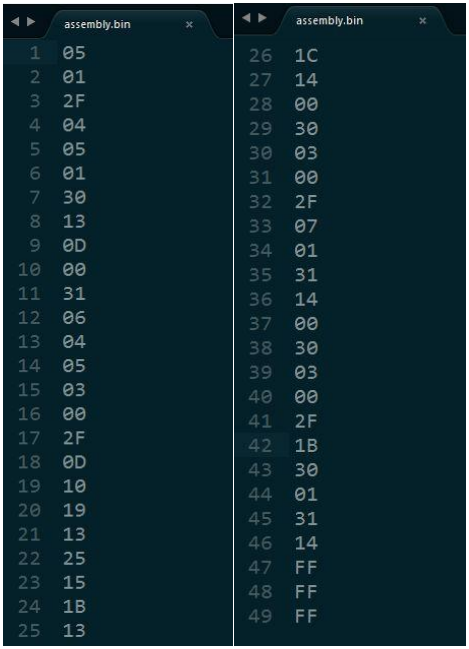
[picture p28: figure]

How to Operate this 4-bit machine:

- Convert the pseudocode to corresponding Assembly Language Instructions
- Convert the Instructions into HexCoded Machine Language
- Save them into “assembly.bin” file
- Simulate the Proteus File (RUN)
- Press UP_INIT once to turn it ON
- Press UP_INIT_CLOCK repeatedly until all hex codes in “assembly.bin” gets boot-loaded to the RAM.
- Press PC_SP_SETUP once.
- Press CLK repeatedly to provide clock pulse to the machine until all instructions finish execution.

Special Features:

- We have boot-loader to upload the assembly program to the RAM initially.
- Our memory is divided into three separate segments:
CODE Segment (CS), DATA Segment(DS), STACK Segment(SS).
CS: 1-100------->100
DS: 101-175-----> 75
SS: 176-255 ----> 80

SS is fixed but CS & DS are flexible and user-controlled.

- We have detailed output pins to show what is really going on inside the 4bit Machine. It helps to DEBUG at a large extent.
- To provide more accurate debugging, we intentionally left CLK and UP_INIT_CLK logical toggle instead of using a clock pulse. It helped to see even the CONTROL WORDS generated in each T-State.
- The W-BUS was left neat & clean instead of messy circuitry.

Chip Count:

- AND(74LS08): 11
- OR (74LS32): 04
- NOR (74LS02): 1
- NOT (74LS04): 21
- 4-INPUT-NOR (4002): 1
- 1-BIT-D-FLIP-FLOP (74LS74): 4
- 4-BIT-D-FLIP-FLOP (74LS173): 3
- 6-BIT-D-FLIP-FLOP (74S174): 1
- 8-BIT-D-FLIP-FLOP (74LS374): 1
- 1-BIT-TRISTATE-BUFFER (74LS126): 3
- 4-BIT-TRISTATE-BUFFER (74LS244): 5
- 8-BIT-TRISTATE-BUFFER (74LS241): 8
- EPROM (2732): 7
- RAM (6116): 1
- DUAL 4x1 MUX (74153): 4
- UP-DOWN COUNTER (COUNTER_8): 4
- ALU(FUNCTION_4_4): 1

Discussion:

- This 4 bit pc is functional for 28 instructions only.
- The opcodes for these 28 instructions are fixed and cannot be changed.
- RAM loads address from 1st address instead of 0th
- PC initially starts from 0. So, we had to manually increase “PC_SP_SETUP” to 1 before running the assembly program for synching issues with RAM.
- We put one extra clock “UP_INIT_CLK” for boot-loading into RAM.
- COUNTER_8 & FUNCTION_4_4 are not real chips but are Proteus Packages. For this reason, some control bits in ALU like EADD, ESUB, EAND, EOR are actually implemented with permutated sequence of real status bits.
- The whole machine works in two separate clock edges.
i) In falling edge, controller generates control signals for next T-state of instruction.
ii) | In rising edge, the sequential operations like load, write etc are
| performed for that T-state.

- If more than one component tries to emit data at bus, it gets garbage and we get “logic contention error”.
- Sometimes, keeping a pin floating also gave logic contention error.
- In another approach, it could be done that, the boot-loader could use PC instead of a new counter inside RAM. Then it would need respective design calibrations & modifications.
- In case of Call we PUSH accumulator data, Flag data into Stack and POP when RET.
- In case of returning any value, instead of keeping it into STACK segment (as per as the ideal case), we keep it into the DATA segment of the memory.

- Combinational parts:
i) MAR->RAM
ii) Ram->MDR combinational, but operates in the next clock cycle. iii) IR->CONTROLLER
iv) ACCUMULATOR->ALU
v) TEMP->ALU
vi) OUT->BINARY DISPLAY
- Sequential parts:
i) IN->BUS
ii) PC<-BUS
iii) BUS->MAR
iv) MDR->RAM
v) BUS->MDR,
vi) IR<-BUS
vii) ACCUMULATOR<-BUS
viii) TEMP<-BUS
ix) B<-BUS
x) FLAG<-BUS
xi) BUS->OUT

# T-State Analysis

Special Thanks to:

- Md. Iftekharul Islam Sakib Lecturer, CSE,BUET.
- Md Ishtiyaque Ahmed
Lecturer, CSE,BUET.
