rafibuet12/4bitSAP/Report/CONTROLLER.xlsx

 |  |  | EIN | CP | LPC | EPC | LMAR | RRAM | WRAM | LMDR | || | EMDR | LIR1 | LIR2 | SETZF | ESET_ZF | LA | EA | CIN | || | EALU | EADD | ESUB | EAND | EOR | LTEMP | ETEMP | LB | || | EB | ESP | USP | DSP | LFLAGS | LFLAG_Z | EFLAGS | LOUT | || | CTRL | CTRR | CTRC | CTRZ | SADD | HLT | 0 | 0
FETCH | 0 | T1 |  |  |  | 1 | 1
 | 1 | T2 |  | 1 |  |  |  | 1
 | 2 | T3 |  |  |  |  |  |  |  |  |  | 1 | 1 |  |  |  |  |  |  |  |  |  |  |  |  |  |  |  |  |  |  |  |  |  |  |  |  |  | 1
LDA |  | T4 |  |  |  | 1 | 1
 |  | T5 |  | 1 |  |  |  | 1
 |  | T6 |  |  |  |  | 1 |  |  |  |  | 1
 |  | T7 |  |  |  |  |  | 1
 |  | T8 |  |  |  |  |  |  |  |  |  | 1 |  |  |  |  | 1 |  |  |  |  |  |  |  |  |  |  |  |  |  |  |  |  |  |  |  |  |  |  | 1
STA |  | T4 |  |  |  | 1 | 1
 |  | T5 |  | 1 |  |  |  | 1
 |  | T6 |  |  |  |  | 1 |  |  |  |  | 1
 |  | T7 |  |  |  |  |  |  |  | 1 |  |  |  |  |  |  |  | 1
 |  | T8 |  |  |  |  |  |  | 1 |  |  |  |  |  |  |  |  |  |  |  |  |  |  |  |  |  |  |  |  |  |  |  |  |  |  |  |  |  |  | 1
MOV ACC,B |  | T4 |  |  |  |  |  |  |  |  |  |  |  |  |  |  | 1 |  |  |  |  |  |  |  |  |  |  |  |  | 1 |  |  |  |  |  |  |  |  |  | 1
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
