rafibuet12/4bitSAP/Proteus Files+Others/SHOTS/ASSA.JPG

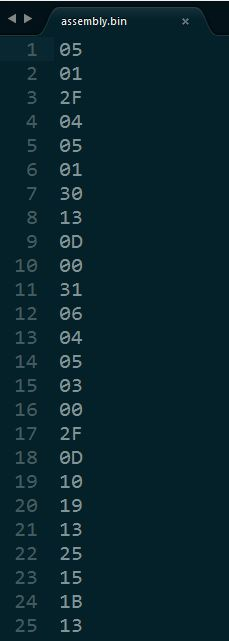
Proteus Files+Others/SHOTS/ASSA.JPG
