rafibuet12/4bitSAP/Proteus Files+Others/SHOTS/ASSB.JPG

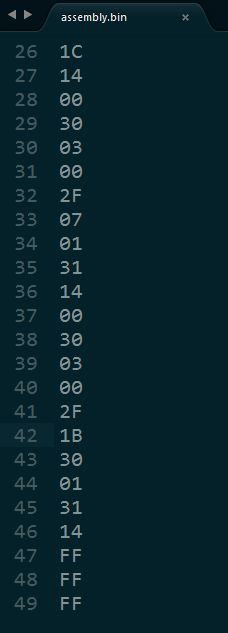
Proteus Files+Others/SHOTS/ASSB.JPG
