rafibuet12/4bitSAP/Proteus Files+Others/SHOTS/BIN4B.JPG

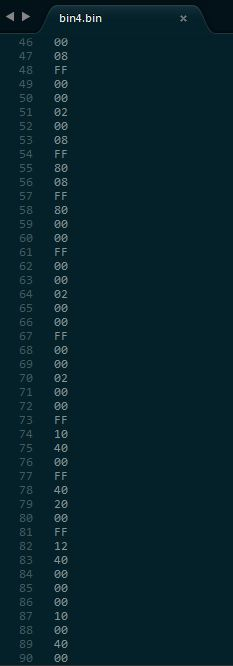
Proteus Files+Others/SHOTS/BIN4B.JPG
