rafibuet12/4bitSAP/Proteus Files+Others/SHOTS/BIN5A.JPG

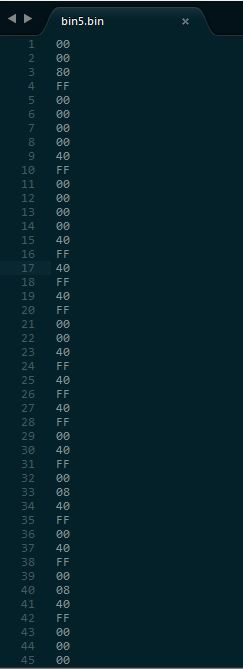
Proteus Files+Others/SHOTS/BIN5A.JPG
