rafibuet12/4bitSAP/Proteus Files+Others/SHOTS/pseudocode.JPG

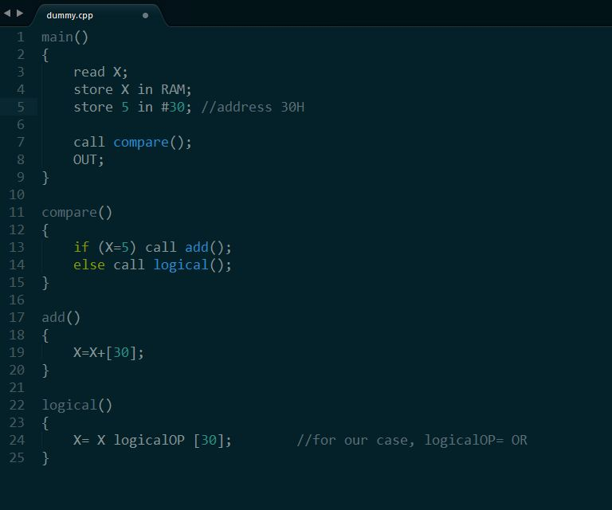
Proteus Files+Others/SHOTS/pseudocode.JPG
