rafibuet12/4bitSAP/Report/alu.bmp

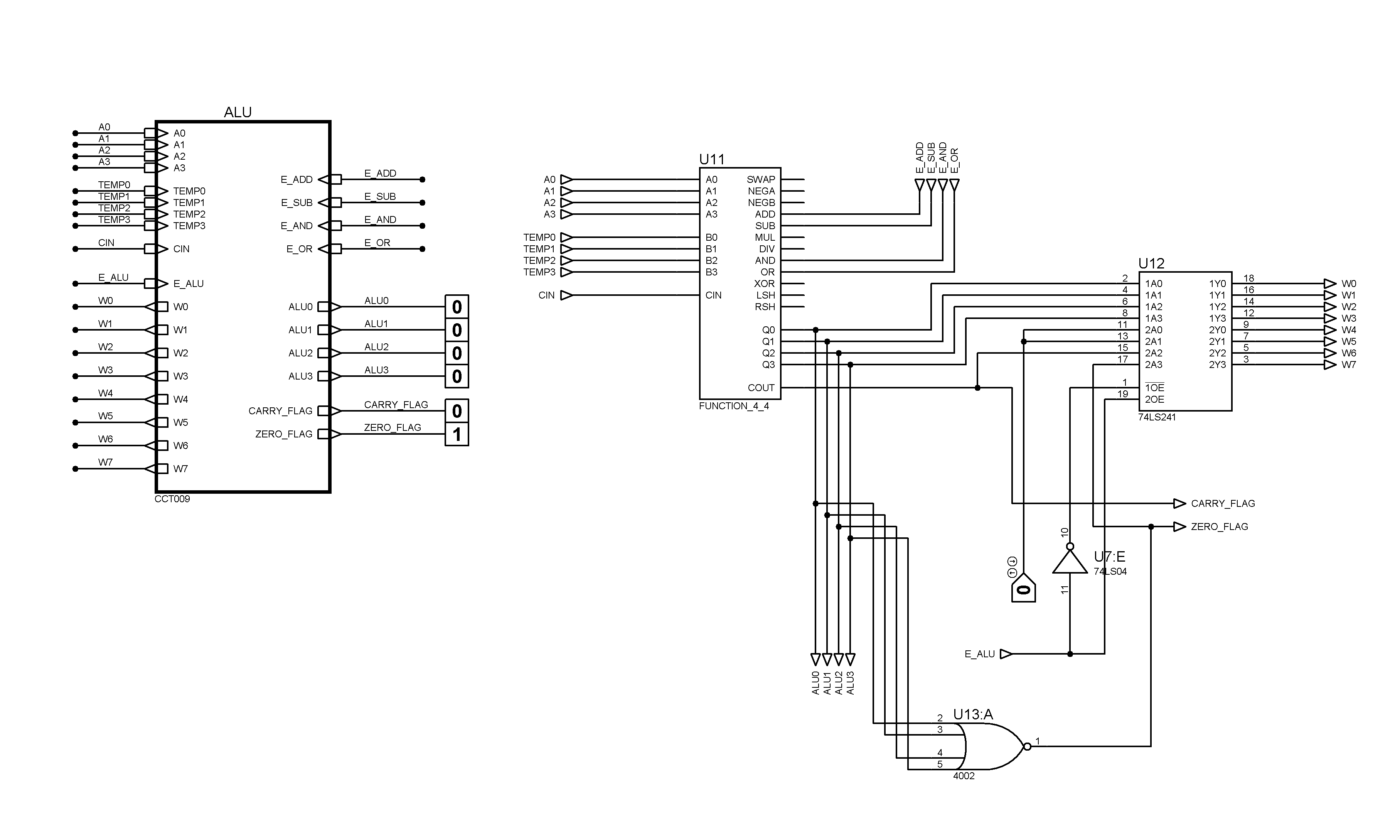
Report/alu.bmp
