rafibuet12/4bitSAP/Report/BLOCKDIAGRAM.jpg

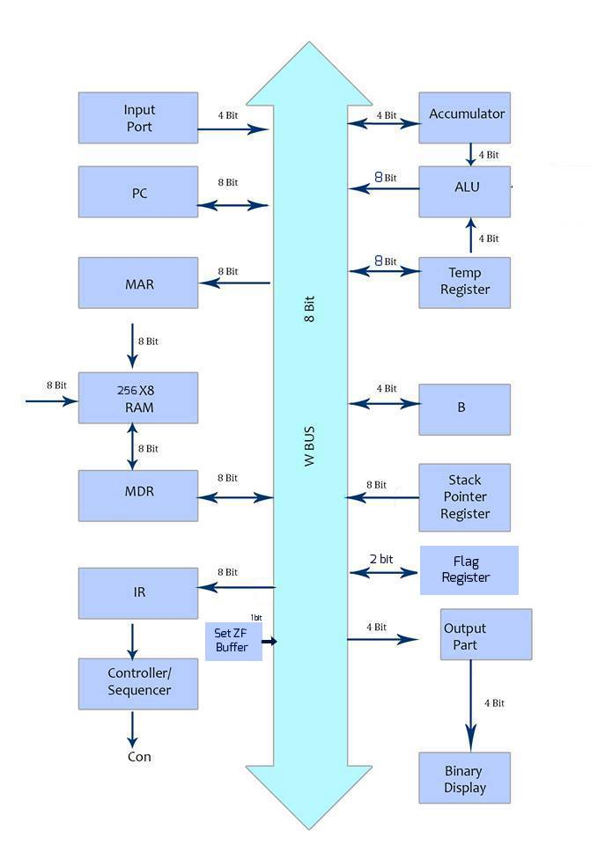
Report/BLOCKDIAGRAM.jpg
