rafibuet12/4bitSAP/Report/controller-child-eprom.bmp

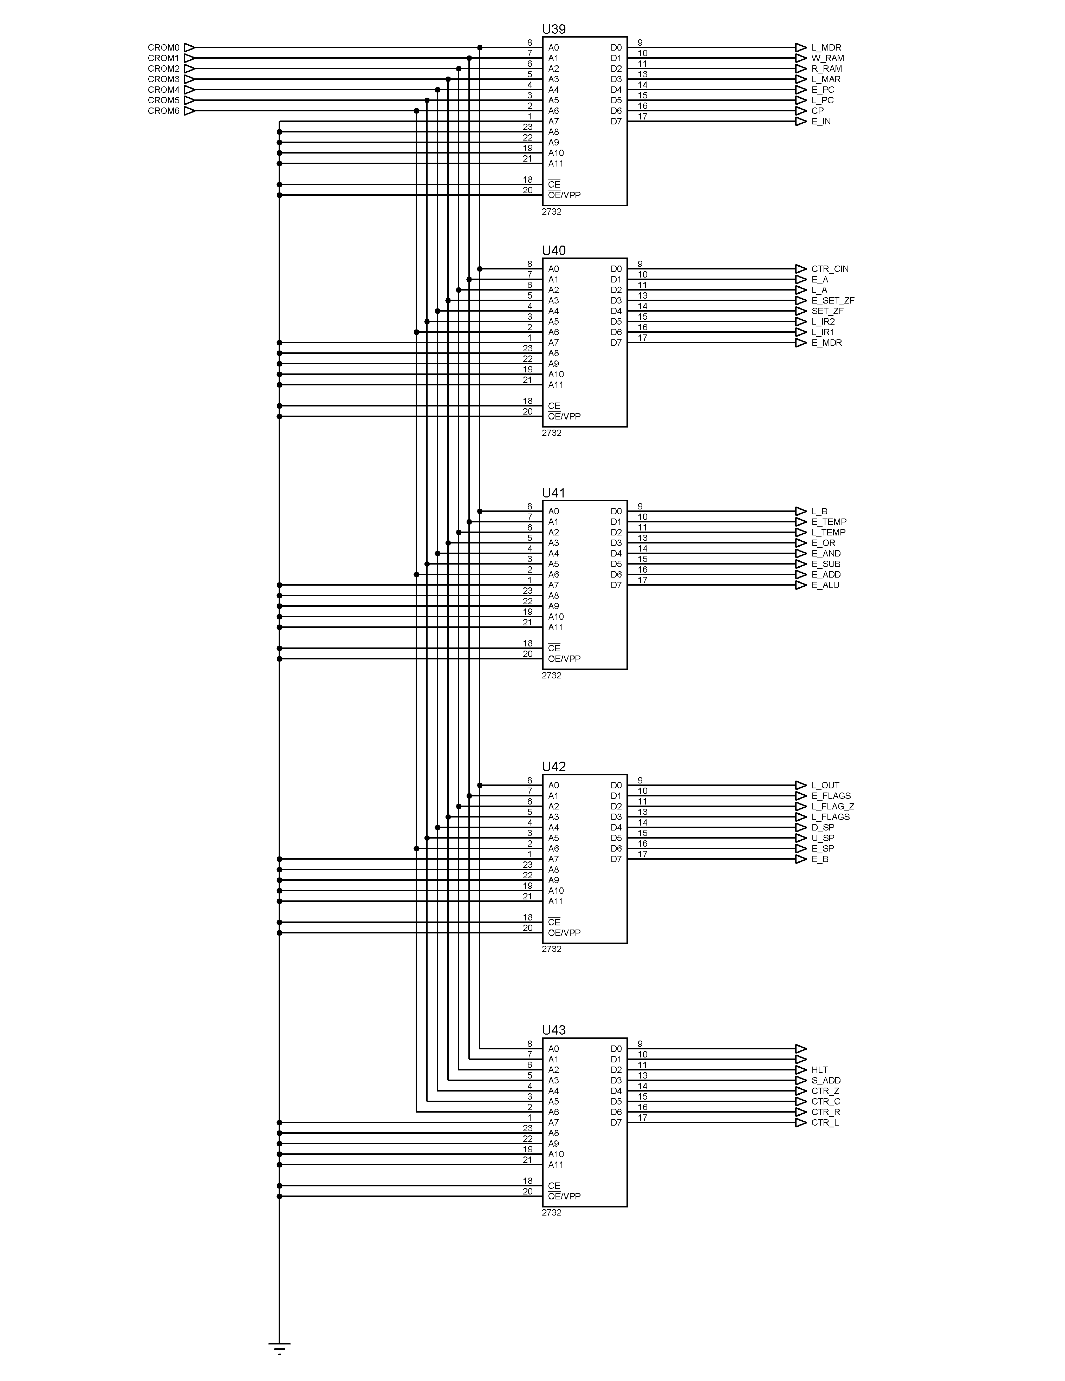
Report/controller-child-eprom.bmp
