rafibuet12/4bitSAP/Report/stack-pointer.bmp

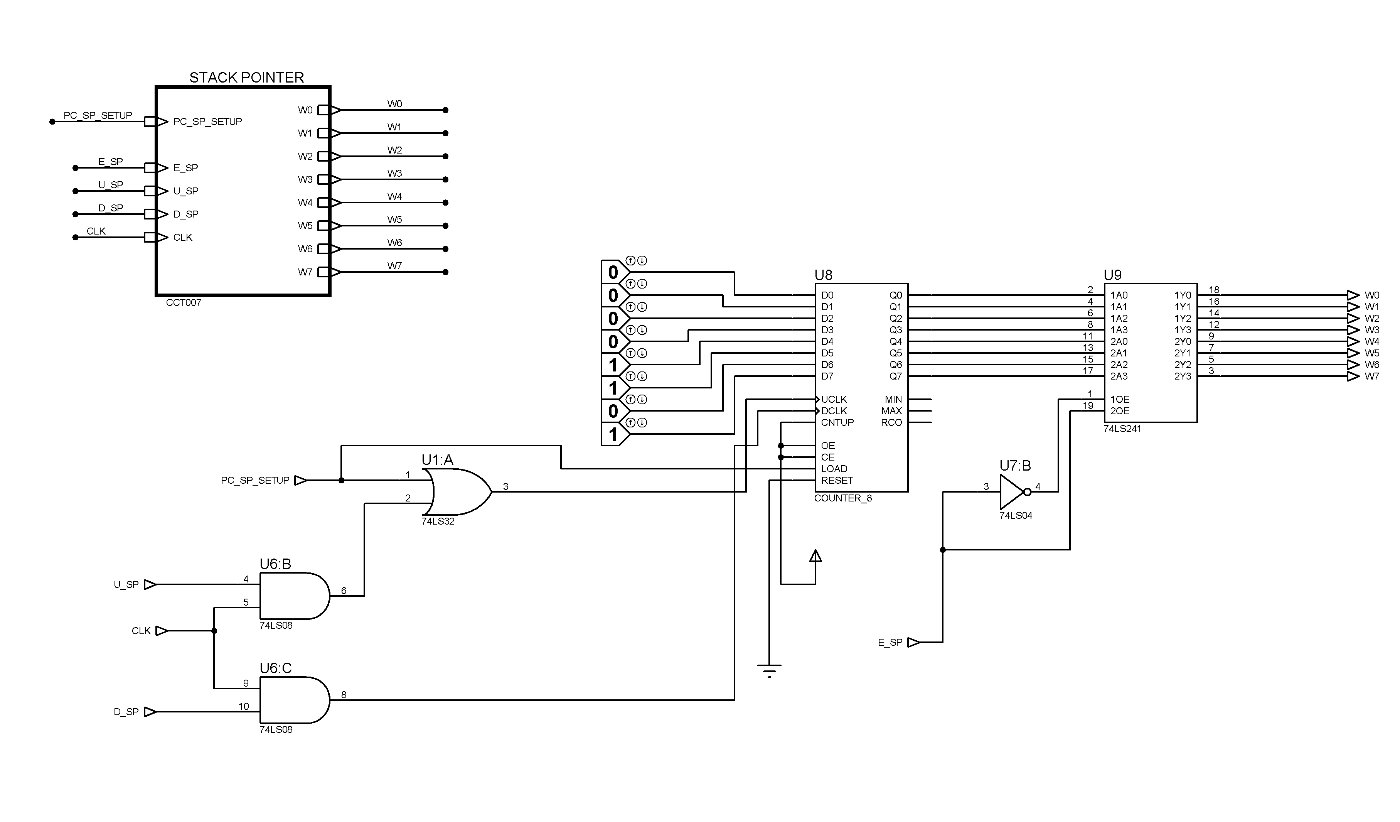
Report/stack-pointer.bmp
