rafibuet12/4bitSAP/(list of files, drawings)

Other design files:
Proteus Files+Others/test.DSN
Proteus Files+Others/test.pdsprj
